danielmoreno510/danny-robot/documentation/research-and-requirements.md

# Investigación y requisitos

**Etapa 1, cerrada salvo la 1.2.** Las cifras de comparación salen de
`analysis/compare_actuators.py` y `results/actuator_comparison.json`.

**Etiquetas:** **V**, dato del fabricante o del proyecto. **S**, tienda. **E**, estimación. **?**,
desconocido.

## 1. Decisiones del usuario (31 de octubre de 2026)

| Tema | Decisión |
|---|---|
| Referencia | El XGO-Duck inspira, no se copia: cada pieza se elige por lo que necesita |
| Forma | Humanoide con aspecto de Tesla Optimus, en pequeño |
| Tamaño | 40 cm: 395 mm en el diseño actual. Sustituye a los 32-36 cm iniciales, que daban aspecto de muñeco |
| Presupuesto | Hasta 1 500 € con repuestos, sin impresora, herramientas ni ordenador de entrenamiento |
| Ordenador | Radxa Zero 3W con cámara, confirmada por el usuario. La Raspberry Pi 5 no cabe en el torso |
| Voz | Hablar con Danny mediante IA en la nube, como objetivo deseable con espacio reservado |
| Entrenamiento | mjlab en la RTX 3080 Ti, en lugar de Isaac Lab |
| Impresora | Cerrada multimaterial |
| Prioridad | Caminar natural y levantarse. El resto, si el diseño lo permite |
| Orden | Diseñar antes de comprar. Medir el servo queda para la etapa 5.1 |

## 2. Requisitos y criterios

Se comprueban en el robot real. Pueden cambiar con justificación escrita.

| Id | Requisito | Criterio | Nivel |
|---|---|---|---|
| R1 | Caminar natural | 0,25 m/s en interior, 5 minutos sin caer, con braceo y giro de torso | Obligatorio |
| R2 | Levantarse | Desde boca arriba y boca abajo, 8 de 10 intentos | Obligatorio |
| R3 | Gestos | Saludo y baile de cuerpo entero sin caer | Obligatorio |
| R4 | Masa | 1,8 kg o menos sin manos y 1,9 kg con manos, medidos. Sube desde 1,6 kg por los 40 cm | Obligatorio |
| R5 | Autonomía | 20 minutos caminando | Obligatorio |
| R6 | Coste | 1 500 € o menos | Obligatorio |
| R7 | Trotar | Pasos rápidos a 0,4 m/s; fase de vuelo si se logra | Deseable |
| R8 | Saltar | Ambos pies a 1 cm del suelo y aterrizar de pie | Deseable |
| R9 | Manipular | Coger con visión un objeto de 50 g de una mesa | Deseable |
| R10 | Proporciones | Altura de 380 a 410 mm, pierna 49 % o más y hombros 34 % o menos de la altura | Obligatorio |
| R11 | Conversación | Responder por voz, con wifi, usando un servicio en la nube, y lanzar un gesto conocido | Deseable |

Se reserva desde el diseño espacio, masa y bus para R9: muñeca, pinza y cámara. Los límites térmicos
se fijan al medir el servo, en la etapa 5.1.

## 3. Referencias

| | XGO-Duck | Microduck | Open Duck Mini | ToddlerBot | Zeroth Bot |
|---|---|---|---|---|---|
| Altura | ? | 25 cm V | 42 cm V | 56 cm V | 48 cm (tabla de ToddlerBot) |
| Masa | ? | Menos de 800 g V | 2,1 kg de modelo V | 3,4 kg V | 3,6 kg (tabla de ToddlerBot) |
| GDL | 15 V | 15 V | 14 V | 30 V | 16 (tabla) |
| Servo | HD-1910-C001 V | XL330 V | STS3215 V | Dynamixel V | Feetech, modelo ? |
| Brazos | No | No | No | Sí | Sí |
| Ordenador | UNO Q V | RK3566 V | Pi Zero 2W V | Jetson Orin NX V | ? |
| Precio | Unos 400 $ | 399 $ V | 398 € V | Unos 6 000 $ V | 350 $ a 1,4 k$, en conflicto |
| Entrenamiento | mjlab, PPO, BAM V | mjlab, PPO, BAM V | MuJoCo Playground V | MJX, Brax V | K-Sim V |

**Conclusiones:**

- **Receta probada para este tamaño:** mjlab, PPO, 50 Hz, modelos de actuador BAM, aleatorización de
  dominio, simulación de holgura y exportación a ONNX. Microduck indica 1-2 horas para una marcha
  usable con 4 096 entornos.
- **Reutilizable:** el código de `xgoduck_rl` es Apache 2.0 e incluye un modelo BAM del servo
  (`1910_m6.json`). `microduck_rl` trae además una guía de recetas de entrenamiento.
- **No reutilizable sin permiso:** las piezas de XGO-Duck, sin licencia final según su `LICENSING.md`.
  Diseñamos las nuestras.
- **Sin precedente:** no he encontrado ningún humanoide con brazos que camine con HD-1910. Es el mayor
  riesgo del proyecto.

## 4. Comparación de actuadores

| Servo | Tensión | Bloqueo | Nominal | Vacío | Masa | Precio |
|---|---|---|---|---|---|---|
| Feetech HD-1910-C001 | 7,4 V (máx. 8,4) | 1,47 N·m V | 0,36 N·m V | 11,9 rad/s V | 21 g V | 29,95-32,95 € S |
| STS3215 C018 | 12 V | 2,94 N·m S | 0,98 N·m S | 4,7 rad/s S | 55 g S | 26,51 € S |
| STS3215 C044 | 7,4 V | 1,6 o 2,7 N·m, en conflicto S | 0,88 N·m S | 9,0 rad/s S | 55 g S | 21,89-23,57 € S |

El HD-1910 tiene reducción 1:320, motor sin núcleo, holgura hasta 0,5° y encoder de 12 bits (V). Las
fichas del HD-1910 discrepan en el par: 10 kg·cm a 6 V en la wiki de Feetech, y 12 kg·cm a 6 V y 15 kg·cm
a 7,4 V en la ficha del proveedor que recoge el XGO-Duck. Se usa esta última, la más optimista: hay que
confirmarla al medir. **El par continuo real está sin medir.**

Primer orden con 12 servos de pierna, margen de 1,5 y velocidad en vacío como techo:

| Reparto, 40 cm, 23 GDL | Masa | Par pico con margen | Supera nominal | Marcha humana equivalente | Salto cargado |
|---|---|---|---|---|---|
| **Todo HD-1910** | 1,78 kg | 65 % del bloqueo | Sí | **1,12 m/s** | 2,1 cm |
| Piernas C044, arriba HD-1910 | 2,19 kg | 73 % del bloqueo | Sí | 0,85 m/s | 1,2 cm |
| Todo C018 | 2,56 kg | 47 % del bloqueo | Sí | 0,44 m/s | 0,3 cm |

Con 27 GDL y todo HD-1910, 1,87 kg y 68 %. Es la estimación alta: la pieza a pieza da 1,66 kg.

**Lectura:**

- **Candidato: todo HD-1910.** Mezclar con STS3215 en las piernas pesa más y va más lento. El C018
  necesita además 12 V, por encima de los 8,4 V del HD-1910.
- **Punto débil: el calor.** Los picos superan los 0,36 N·m nominales. Hay que medir si aguanta el
  apoyo a un pie. Si no, las opciones son reducir masa o reforzar solo las articulaciones
  que fallen.
- **Saltar y correr:** con la reducción 1:320, el salto estimado es de unos 2 cm, con techo teórico de 6
  cm. La velocidad en vacío no se alcanza bajo carga, y el 60 % usado es una estimación. El aterrizaje
  no está evaluado y puede dañar los engranajes. R7 y R8 pueden requerir actuadores de menor reducción.

Este estudio simplifica mucho: la masa de estructura se escala desde Open Duck, ignora la curva
par-velocidad y no incluye levantarse, que puede ser la carga mayor en los hombros.

**Datos de diseño del HD-1910 (S, ArmDojo):** 29 mm de grosor con ambos ejes; eje doble para horquillas;
dos conectores para encadenar servos; lee posición, carga, corriente, tensión y temperatura; modo PD de
posición; corte por temperatura a 80 °C; 2S llena llega a 8,4 V, el máximo del servo.

**Riesgo de diseñar antes de medir:** el calor y la curva real se conocerán en la etapa 5.1. Si fallan,
habrá que rediseñar las piezas que sujetan el servo, y volver a entrenar.

## 5. Precios del banco de pruebas

Consultados el 31 de octubre de 2026, como referencia. El usuario ya compró 3 servos, FE-URT-2 y fuente.

| Concepto | Vendedor | Precio | Disponibilidad |
|---|---|---|---|
| 2 HD-1910-C001 | OpenELAB | 63,96 € con IVA (31,98 € cada uno) | Envío desde China en 5-10 días laborables |
| FE-URT-2 | OpenELAB | 15,96 € | No comprobada |
| 15 HD-1910 + FE-URT-2 | ArmDojo | 393,95 €, sin IVA ni aranceles | En stock, desde Singapur |
| Fuente de 3-12 V, 5 A | ArmDojo | 17,95 €, enchufe de EE. UU. | No comprobada |

**Total estimado: 100-120 € (E)**, con fuente y envío. Falta una carga conocida para identificar el servo: un
brazo impreso y botellas de agua pesadas en la báscula. A 100 mm del eje, el bloqueo de 0,94 N·m equivale a unos
0,96 kg. Falta también confirmar cómo entra la alimentación en la FE-URT-2: lo encontrado apunta a bornes de tornillo,
sin manual oficial leído. No pude leer RCDrone.

## 6. Fuentes de movimiento humano (etapa 1.2)

Investigado el 4 de noviembre de 2026 en las páginas oficiales de cada fuente. Las licencias de CMU, 100STYLE y LAFAN1 se
volvieron a leer en su página. No es asesoría legal. El repositorio es público y aún no tiene licencia, así que importa poder
publicar las trayectorias retargeteadas al robot, no solo usarlas.

| Fuente | Licencia | Publicar trayectorias de Danny | Uso comercial | Formato | Contenido útil |
|---|---|---|---|---|---|
| [CMU Mocap](http://mocap.cs.cmu.edu/) | Propia: "copied, modified, or redistributed without permission" | Sí, sin revender los datos | Sí, dentro de un producto | ASF/AMC y c3d; sin SMPL | Andar, gestos, bailes y sentarse. Que tenga levantarse del suelo no está comprobado |
| [100STYLE](https://www.ianxmason.com/100style/) | CC BY 4.0 | Sí, citando "The 100STYLE Dataset - Ian Mason" | Sí | BVH; sin SMPL | Solo locomoción: 100 estilos hacia delante, atrás y de lado, con transiciones |
| [Bandai Namco Research](https://github.com/BandaiNamcoResearchInc/Bandai-Namco-Research-Motiondataset) | CC BY-NC 4.0 | Sí, sin fin comercial | No | BVH | Vida diaria, bailes y gestos con estilos |
| [Ubisoft LAFAN1](https://github.com/ubisoft/ubisoft-laforge-animation-dataset) | CC BY-NC-ND 4.0 | **No**: ND prohíbe publicar lo adaptado | No | BVH | Andar, bailar, caer y levantarse. Es la que usan mjlab y BeyondMimic |
| Retargeting de LAFAN1 de Unitree | Hereda NC-ND de LAFAN1 | No | No | CSV para G1 y H1 | El de LAFAN1, para otro robot |
| [AMASS](https://amass.is.tue.mpg.de/license.html) y modelo SMPL/SMPL-X | Propia de MPI, investigación no comercial | No | No | SMPL | Más de 40 h; necesita registro |
| SFU, Motion-X, HumanML3D | No comercial; SFU no aclara la redistribución | No o sin aclarar | No | Varios | Repiten lo anterior |
| KIT Whole-Body | Sin licencia publicada | Sin verificar | Sin verificar | c3d | Habría que preguntar a KIT |
| Mixamo | Los términos de Adobe prohíben entrenar aprendizaje automático con sus resultados (sección 17(C)) | No | — | FBX | Descartada |

**Herramientas:** [GMR](https://github.com/YanjieZe/GMR) (MIT) retargetea BVH sin SMPL, así que CMU y 100STYLE no necesitan
el modelo SMPL. mjlab (Apache 2.0) imita movimientos desde CSV con la convención de Unitree. Grabar al usuario con el móvil
(WHAM, GVHMR) depende de SMPL, que no es comercial, y GVHMR solo permite investigación: queda para más adelante.

**Laguna:** ninguna licencia dice si los pesos de una política entrenada cuentan como obra derivada.

**Recomendación:** CMU como base y 100STYLE para estilos de marcha. Permiten publicar todo con cualquier licencia del repositorio.
LAFAN1 solo en local, sin subir lo derivado, y solo si hace falta para levantarse.

**Decisión del usuario, 4 de noviembre de 2026:** CMU y 100STYLE. Se descargan de su página oficial, no de AMASS, cuyos
términos mandarían sobre la copia de CMU que incluye. Se cita "obtained from mocap.cs.cmu.edu" y "The 100STYLE Dataset - Ian Mason".

## 7. Preguntas abiertas de la etapa 1

- Si `1910_m6.json` coincide con nuestros servos: se resuelve en la etapa 5.1. Si HD-1910 y STS3215 conviven en un
  bus solo importa si se llegan a mezclar.
- Otros actuadores compactos para las piernas, para R7 y R8.
- ACDC4Robot: comprobar con un modelo simple que exporta bien a MJCF desde Fusion.

## 8. Fuentes

[XGO-Duck](https://github.com/LuwuDynamics/xgoduck_hardware) ·
[HD-1910 en ArmDojo](https://armdojo.com/products/feetech-hd-1910-c001-coreless-servo-microduck) ·
[Ficha del servo en XGO-Duck](https://github.com/LuwuDynamics/xgoduck_hardware/blob/main/docs/BOM.md) ·
[xgoduck_rl](https://github.com/LuwuDynamics/xgoduck_rl) ·
[Licencias de XGO-Duck](https://github.com/LuwuDynamics/xgoduck_hardware/blob/main/LICENSING.md) ·
[Guía de XGO-Duck](https://xgo-duck.com/) ·
[Compra de servos](https://www.roboduckbuild.com/diary/sixteen-servos-on-pre-order/) ·
[HD-1910 en OpenELAB](https://openelab.io/products/feetech-hd1910-microduck-coreless-servo) ·
[Wiki de Feetech](https://ftservo.github.io/ftservo-wiki/en/products/models/hd-1910-c001/main/) ·
[Microduck](https://pollen-robotics.com/microduck/blog/introducing-microduck/) ·
[Runtime de Microduck](https://github.com/pollen-robotics/microduck) ·
[microduck_rl](https://github.com/pollen-robotics/microduck_rl) ·
[mjlab](https://github.com/mujocolab/mjlab) ·
[BAM](https://github.com/Rhoban/bam) ·
[Open Duck Mini](https://github.com/apirrone/Open_Duck_Mini/tree/v2) ·
[ToddlerBot](https://arxiv.org/html/2502.00893v3) ·
[Zeroth Bot](https://github.com/zeroth-robotics/zeroth-bot) ·
[ACDC4Robot](https://github.com/ACDC4Robot/Fusion360)
