danielmoreno510/danny-robot/cad/export/danny/meshes/right_shin_1.stl

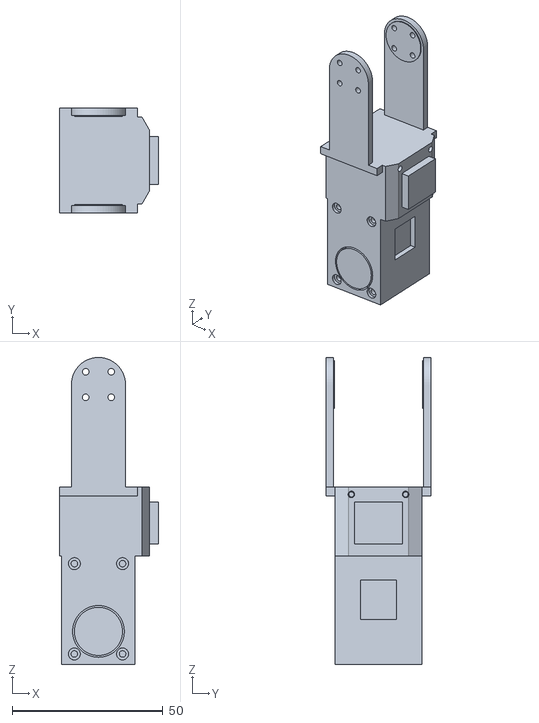
[picture p1: CAD file, 2026-11-02]
cad/export/danny/meshes/right_shin_1.stl
33.0 x 35.0 x 102.0
