danielmoreno510/danny-robot/cad/export/export_test/meshes/arm_link_1.stl

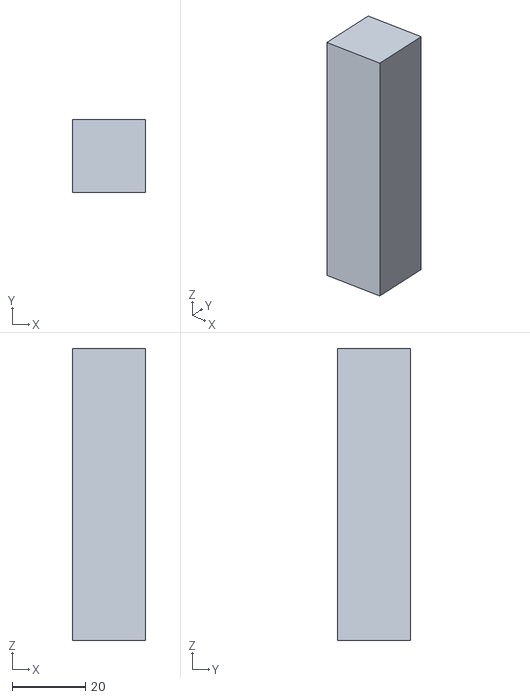
[picture p2: CAD file, 2026-10-31]
cad/export/export_test/meshes/arm_link_1.stl
20.0 x 20.0 x 80.0
