danielmoreno510/danny-robot/cad/print/right_hip_roll_link_cover.stl

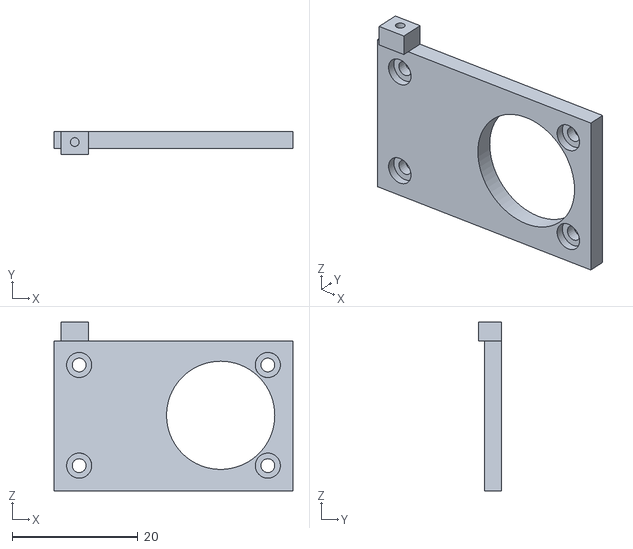
[picture p3: CAD file, 2026-11-02]
cad/print/right_hip_roll_link_cover.stl
38.0 x 3.70 x 26.8
