danielmoreno510/danny-robot/cad/export/danny/meshes/base_link.stl

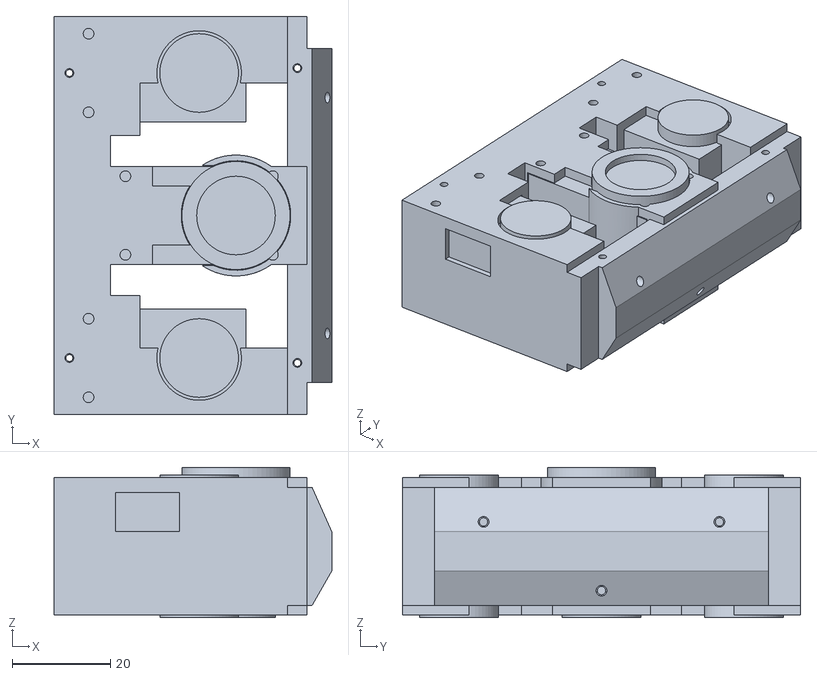
[picture p4: CAD file, 2026-11-02]
cad/export/danny/meshes/base_link.stl
56.5 x 81.0 x 30.6
