danielmoreno510/danny-robot/cad/export/export_test/meshes/base_link.stl

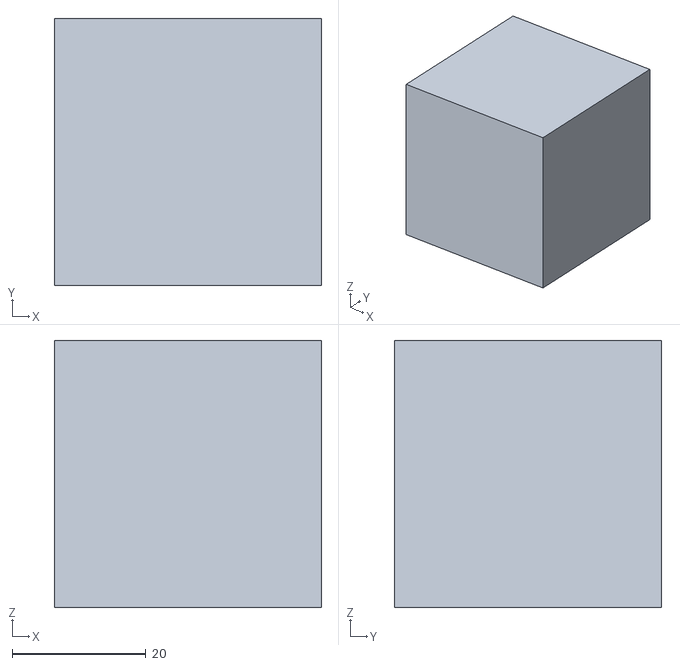
[picture p5: CAD file, 2026-10-31]
cad/export/export_test/meshes/base_link.stl
40.0 x 40.0 x 40.0
