danielmoreno510/danny-robot/cad/print/left_hip_yaw_link_structure.stl

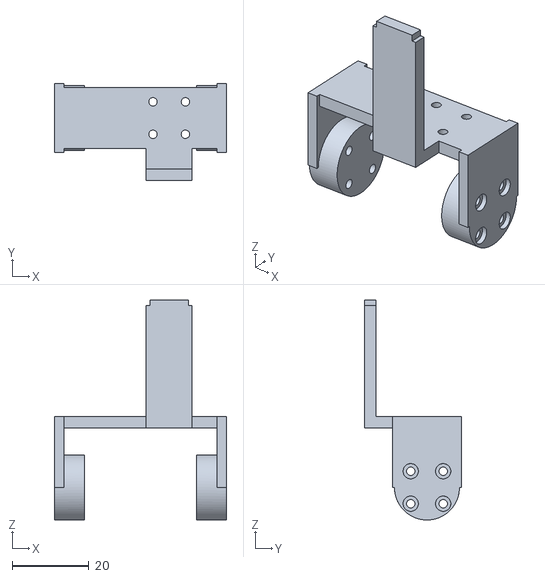
[picture p6: CAD file, 2026-11-02]
cad/print/left_hip_yaw_link_structure.stl
45.0 x 25.3 x 57.5
