danielmoreno510/danny-robot/cad/export/danny/meshes/left_foot_1.stl

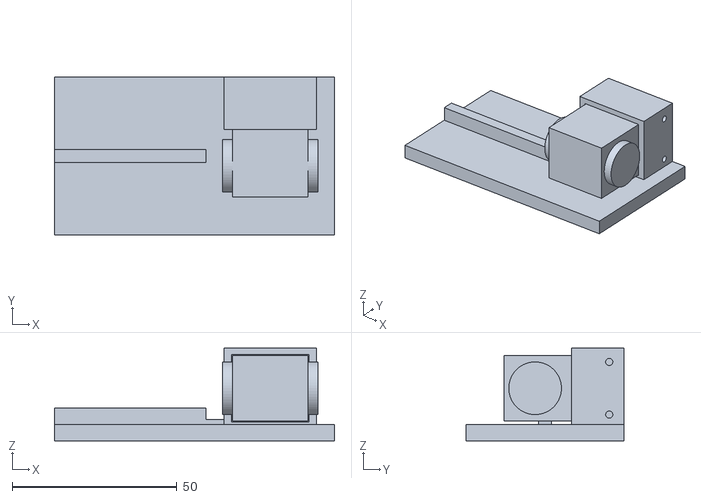
[picture p7: CAD file, 2026-11-02]
cad/export/danny/meshes/left_foot_1.stl
85.0 x 48.0 x 28.2
