danielmoreno510/danny-robot/cad/print/left_hip_yaw_link_cover.stl

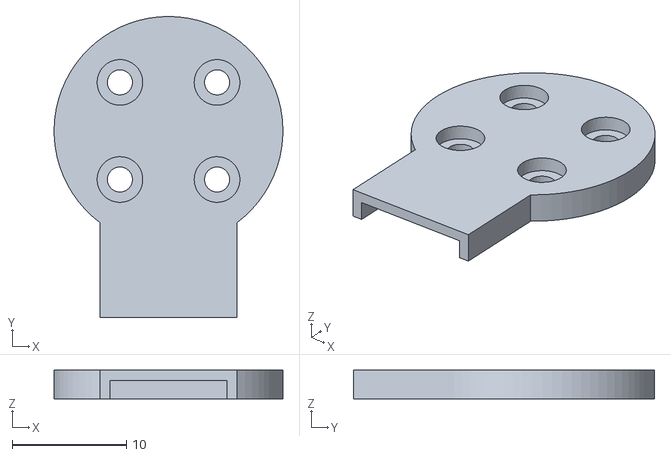
[picture p8: CAD file, 2026-11-02]
cad/print/left_hip_yaw_link_cover.stl
20.0 x 26.3 x 2.50
