danielmoreno510/danny-robot/cad/print/torso_structure.stl

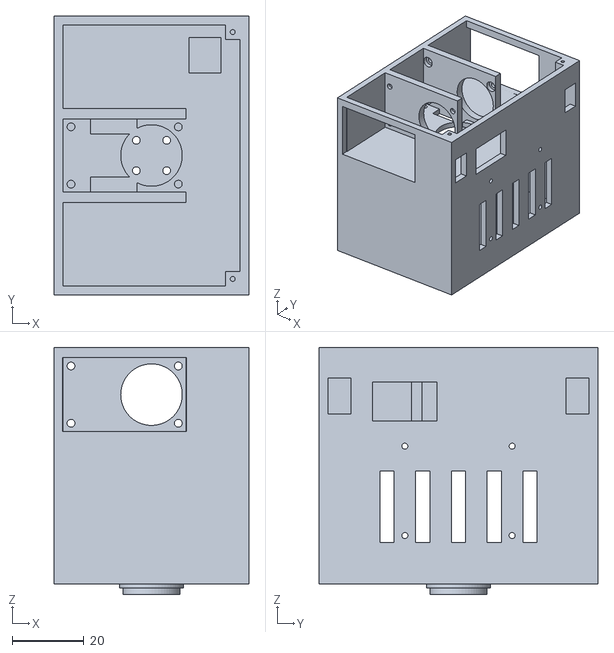
[picture p9: CAD file, 2026-11-02]
cad/print/torso_structure.stl
54.4 x 78.0 x 69.1
