danielmoreno510/danny-robot/cad/export/danny/meshes/torso_1.stl

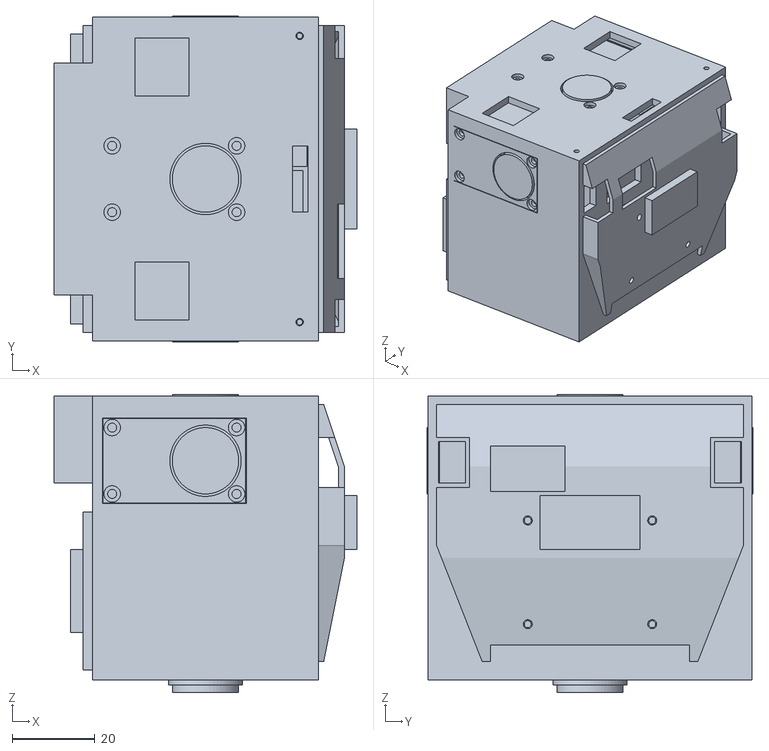
[picture p10: CAD file, 2026-11-02]
cad/export/danny/meshes/torso_1.stl
73.0 x 78.6 x 71.9
