danielmoreno510/danny-robot/cad/print/left_shin_panel.stl

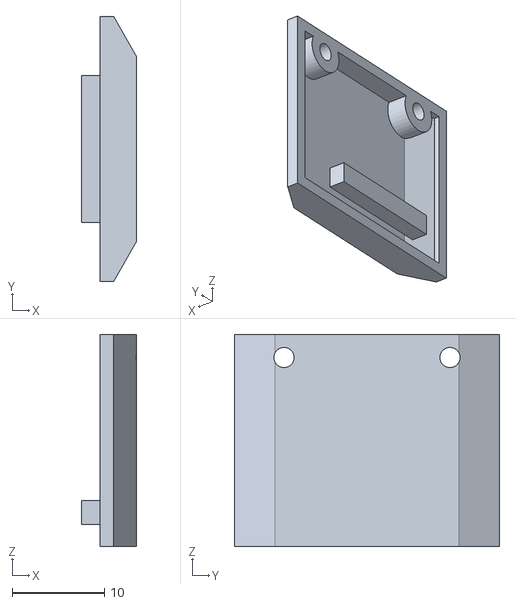
[picture p11: CAD file, 2026-11-02]
cad/print/left_shin_panel.stl
6.00 x 28.8 x 23.0
