danielmoreno510/danny-robot/cad/export/danny/meshes/right_hip_roll_link_1.stl

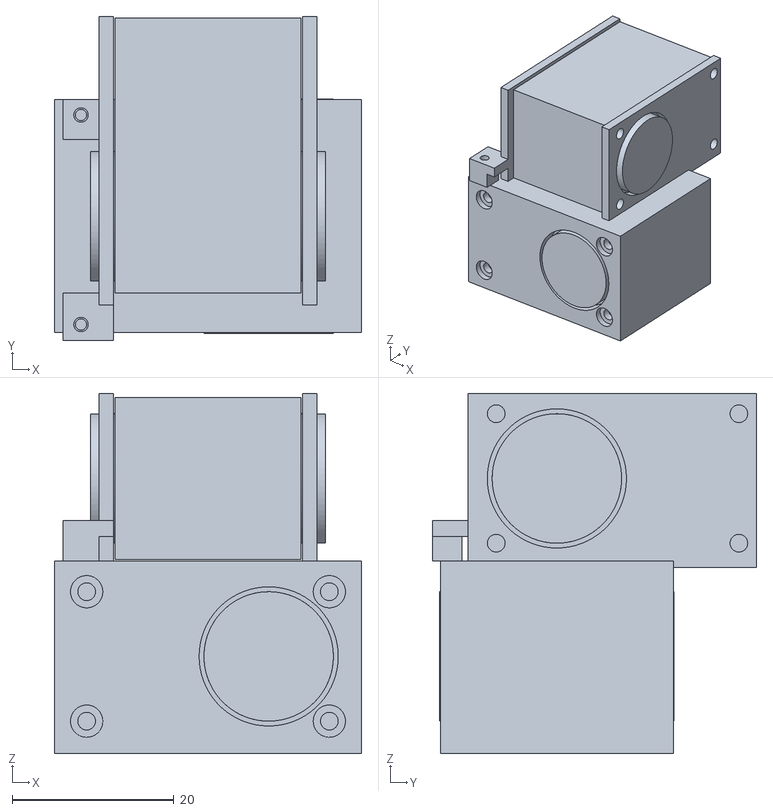
[picture p12: CAD file, 2026-11-02]
cad/export/danny/meshes/right_hip_roll_link_1.stl
38.0 x 40.1 x 44.5
