danielmoreno510/danny-robot/cad/print/right_hip_roll_link_plate.stl

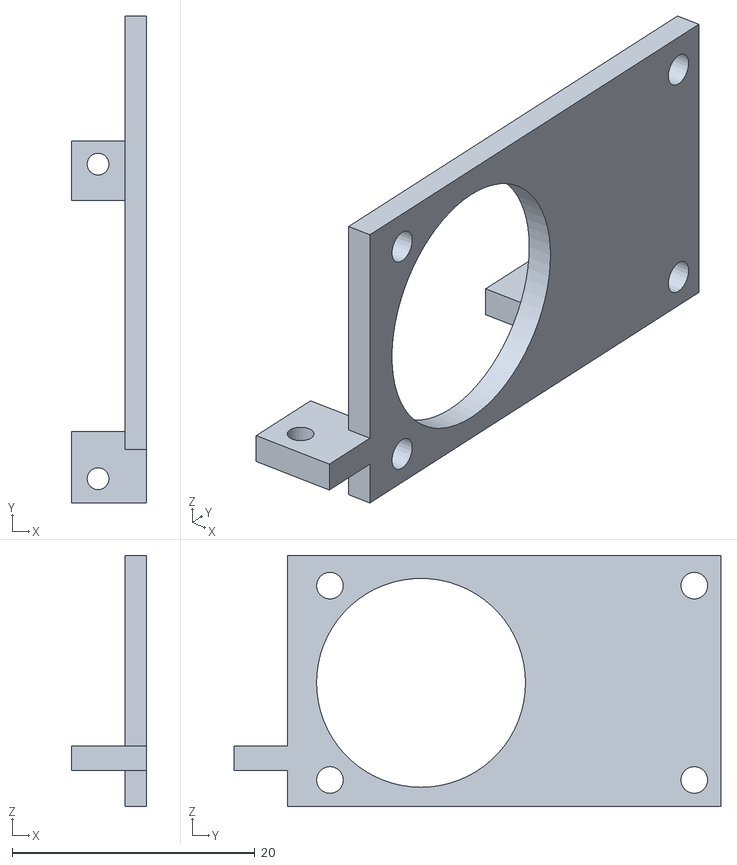
[picture p13: CAD file, 2026-11-02]
cad/print/right_hip_roll_link_plate.stl
6.20 x 40.1 x 20.7
