danielmoreno510/danny-robot/cad/export/danny/meshes/right_thigh_1.stl

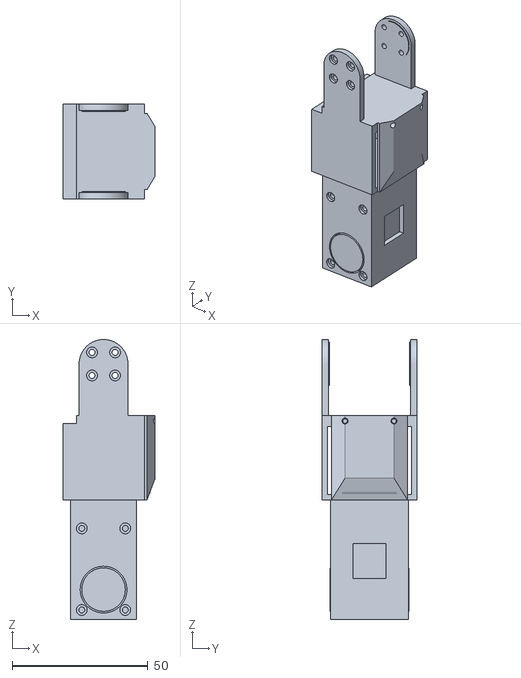
[picture p14: CAD file, 2026-11-02]
cad/export/danny/meshes/right_thigh_1.stl
34.0 x 35.0 x 103.0
