danielmoreno510/danny-robot/cad/export/danny/meshes/right_hip_yaw_link_1.stl

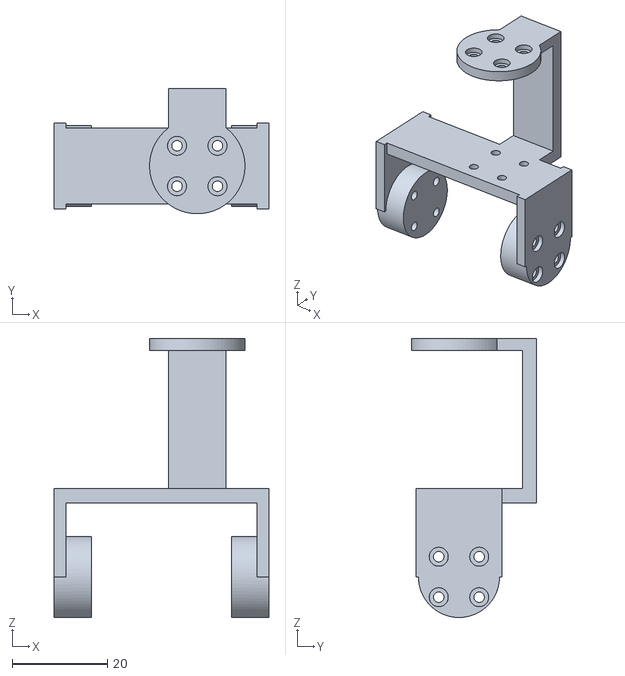
[picture p15: CAD file, 2026-11-02]
cad/export/danny/meshes/right_hip_yaw_link_1.stl
45.0 x 26.3 x 58.5
