danielmoreno510/danny-robot/cad/print/right_thigh_structure.stl

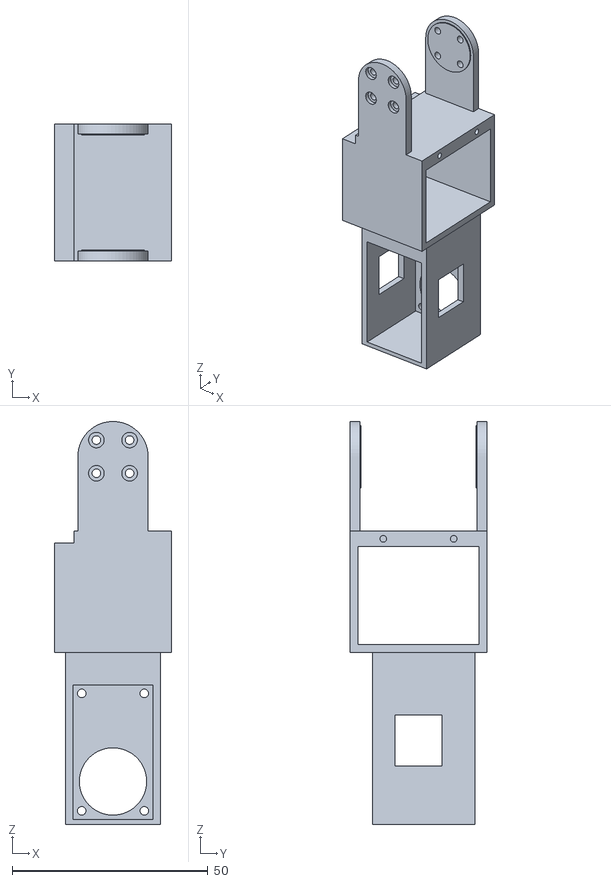
[picture p16: CAD file, 2026-11-02]
cad/print/right_thigh_structure.stl
30.0 x 35.0 x 103.0
