danielmoreno510/danny-robot/cad/print/left_foot_structure.stl

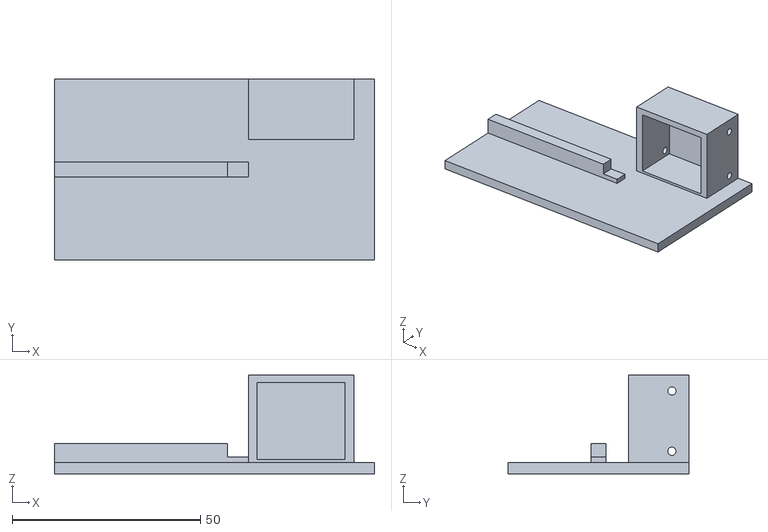
[picture p17: CAD file, 2026-11-02]
cad/print/left_foot_structure.stl
85.0 x 48.0 x 26.2
