danielmoreno510/danny-robot/cad/export/danny/meshes/left_upper_arm_1.stl

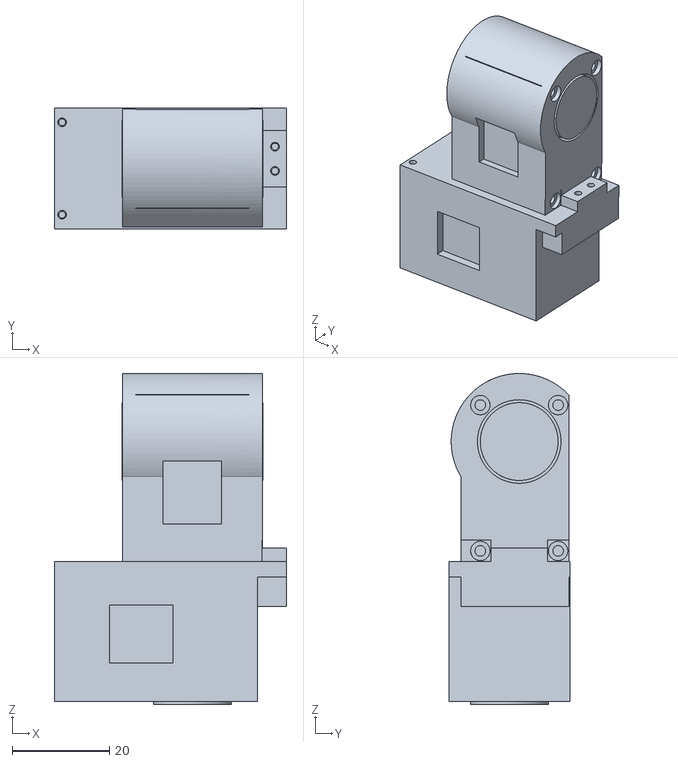
[picture p18: CAD file, 2026-11-02]
cad/export/danny/meshes/left_upper_arm_1.stl
47.8 x 24.8 x 68.1
