danielmoreno510/danny-robot/cad/print/torso_tray_plate.stl

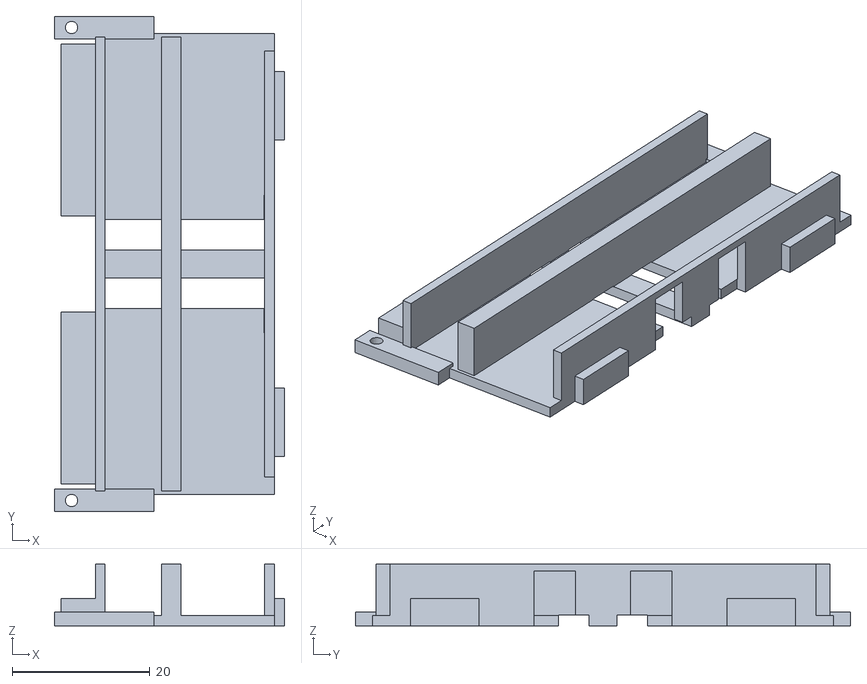
[picture p19: CAD file, 2026-11-02]
cad/print/torso_tray_plate.stl
33.5 x 72.0 x 9.00
