danielmoreno510/danny-robot/cad/print/right_shin_structure.stl

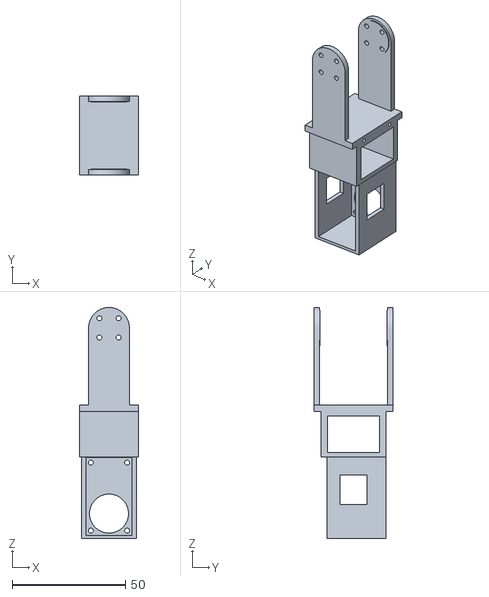
[picture p20: CAD file, 2026-11-02]
cad/print/right_shin_structure.stl
26.0 x 35.0 x 102.0
