danielmoreno510/danny-robot/cad/export/danny/meshes/right_forearm_1.stl

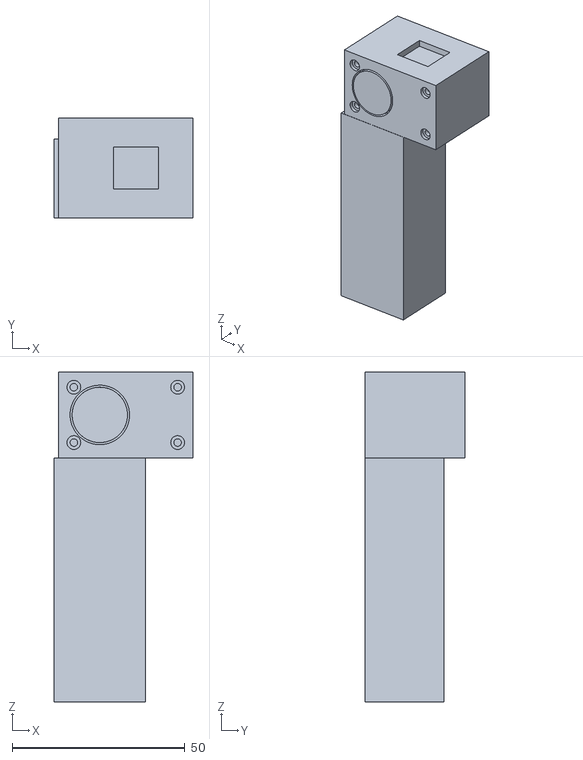
[picture p21: CAD file, 2026-11-02]
cad/export/danny/meshes/right_forearm_1.stl
40.1 x 29.0 x 95.4
