danielmoreno510/danny-robot/cad/export/danny/meshes/right_ankle_link_1.stl

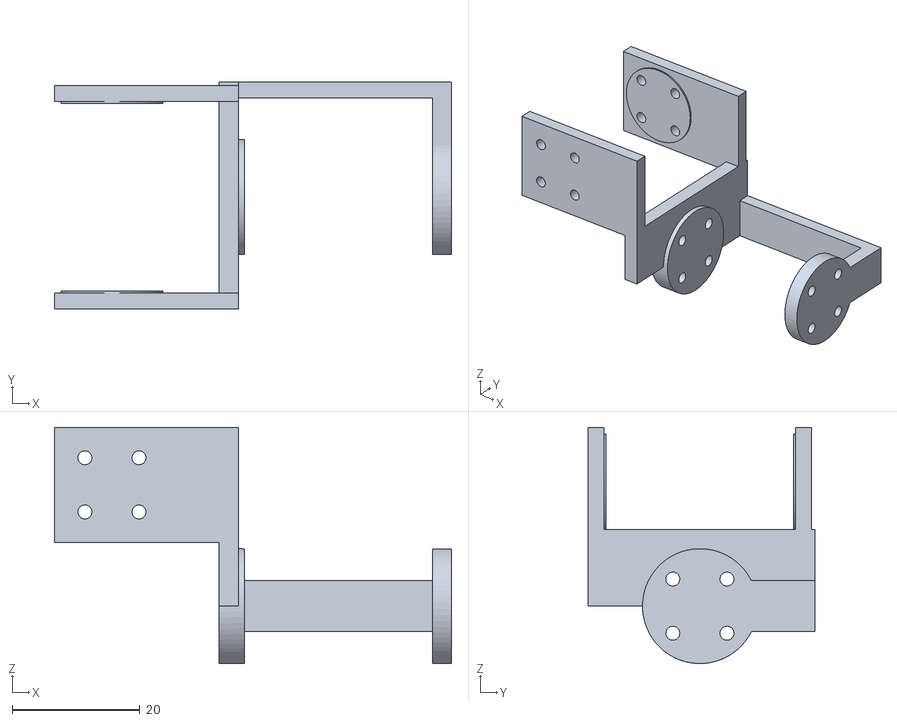
[picture p22: CAD file, 2026-10-31]
cad/export/danny/meshes/right_ankle_link_1.stl
62.2 x 35.5 x 37.0
