danielmoreno510/danny-robot/cad/print/base_link_cover.stl

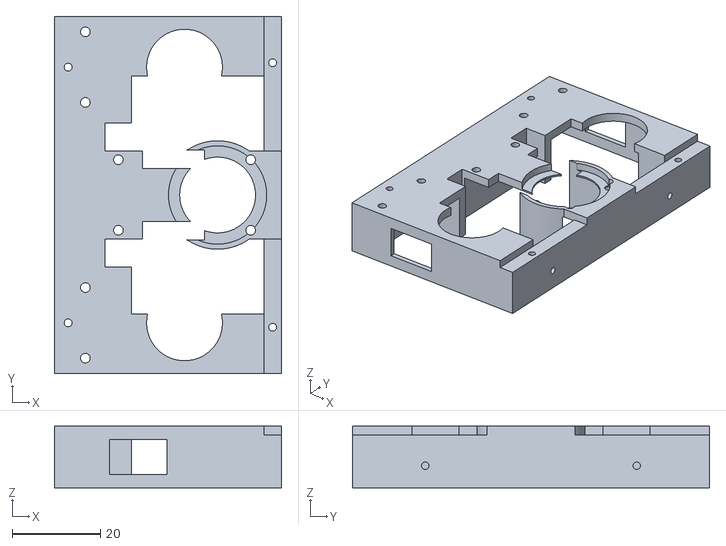
[picture p23: CAD file, 2026-11-02]
cad/print/base_link_cover.stl
51.5 x 81.0 x 14.0
