danielmoreno510/danny-robot/cad/export/danny/meshes/right_elbow_link_1.stl

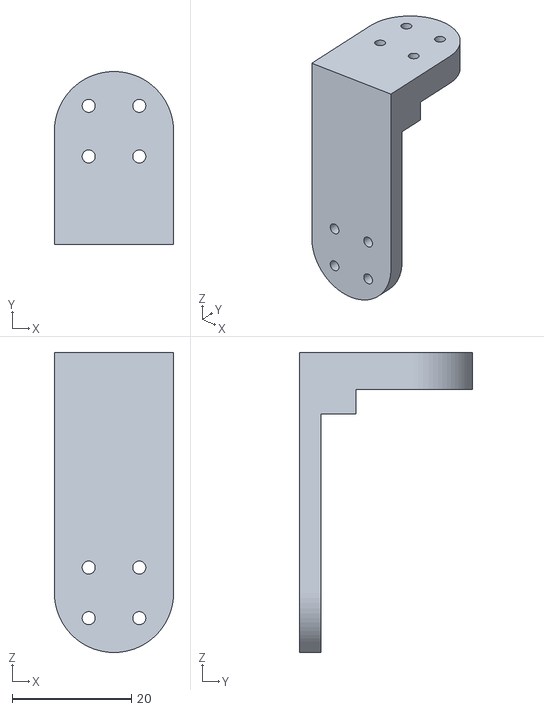
[picture p24: CAD file, 2026-10-31]
cad/export/danny/meshes/right_elbow_link_1.stl
20.0 x 29.0 x 50.3
