danielmoreno510/danny-robot/cad/print/right_hip_roll_link_structure.stl

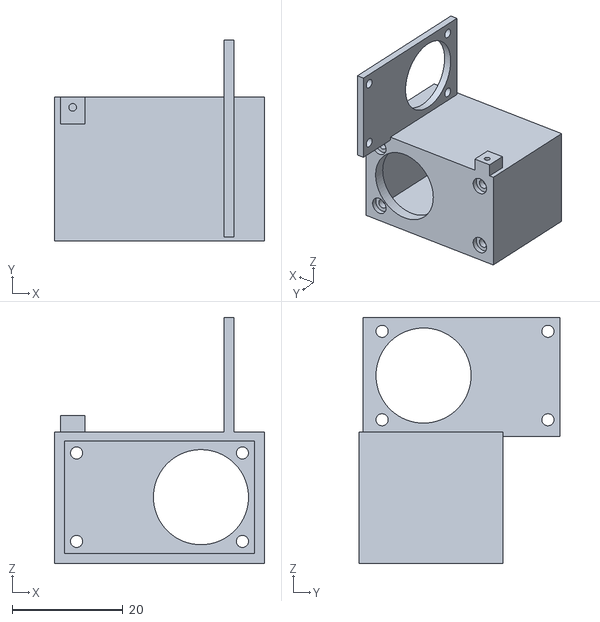
[picture p25: CAD file, 2026-11-02]
cad/print/right_hip_roll_link_structure.stl
38.0 x 36.4 x 44.5
