danielmoreno510/danny-robot/cad/export/danny/meshes/neck_link_1.stl

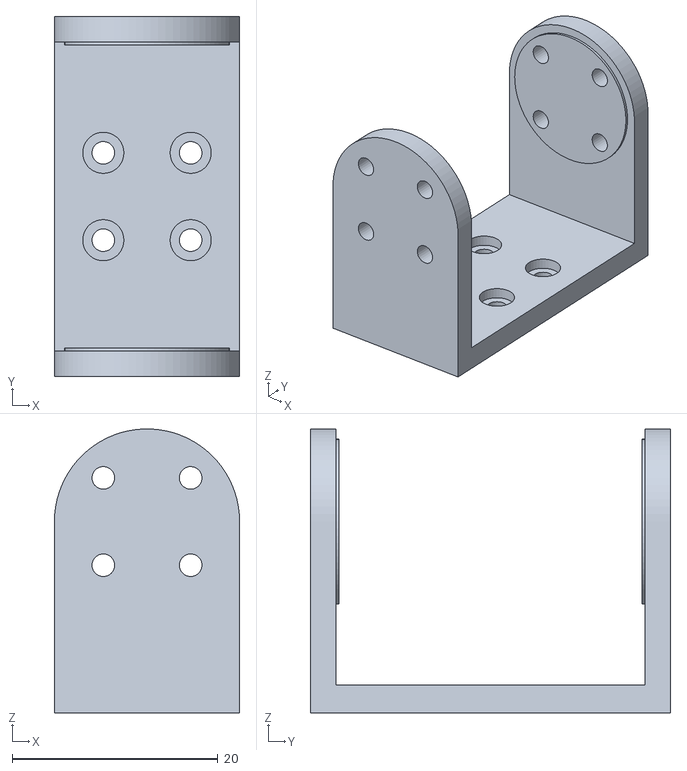
[picture p26: CAD file, 2026-10-31]
cad/export/danny/meshes/neck_link_1.stl
18.0 x 35.0 x 27.6
