danielmoreno510/danny-robot/cad/export/danny/meshes/left_shoulder_link_1.stl

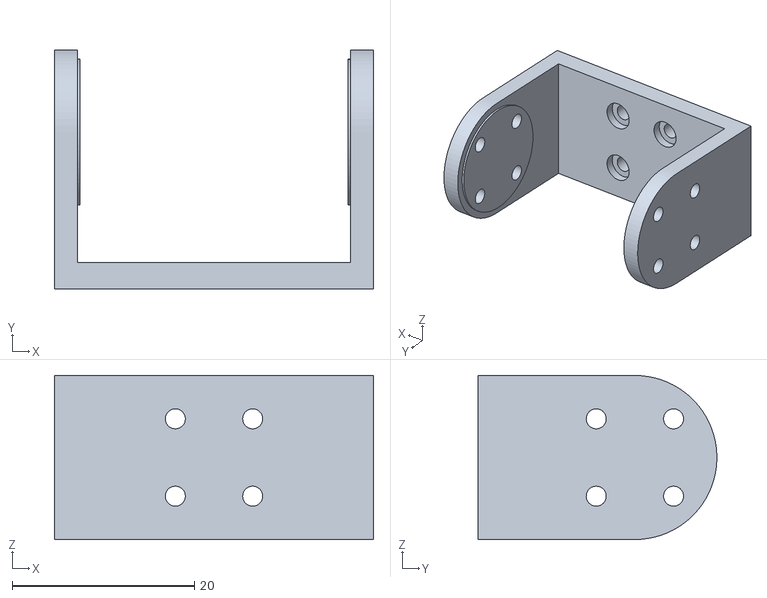
[picture p27: CAD file, 2026-10-31]
cad/export/danny/meshes/left_shoulder_link_1.stl
35.0 x 26.2 x 18.0
