danielmoreno510/danny-robot/cad/print/torso_back_hump_pad.stl

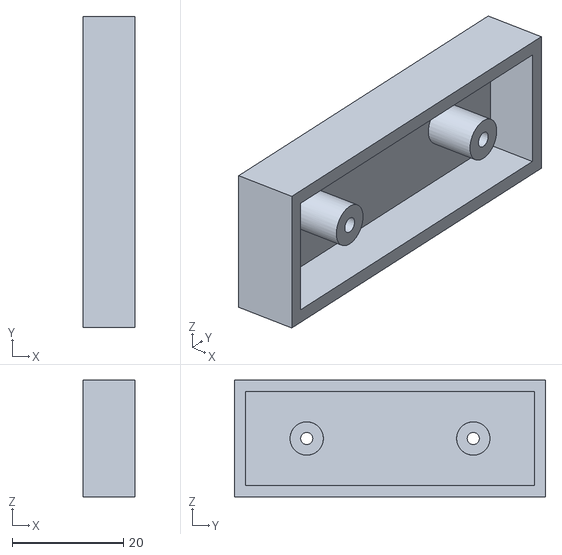
[picture p28: CAD file, 2026-11-02]
cad/print/torso_back_hump_pad.stl
9.30 x 56.0 x 21.0
