danielmoreno510/danny-robot/cad/export/danny/meshes/head_1.stl

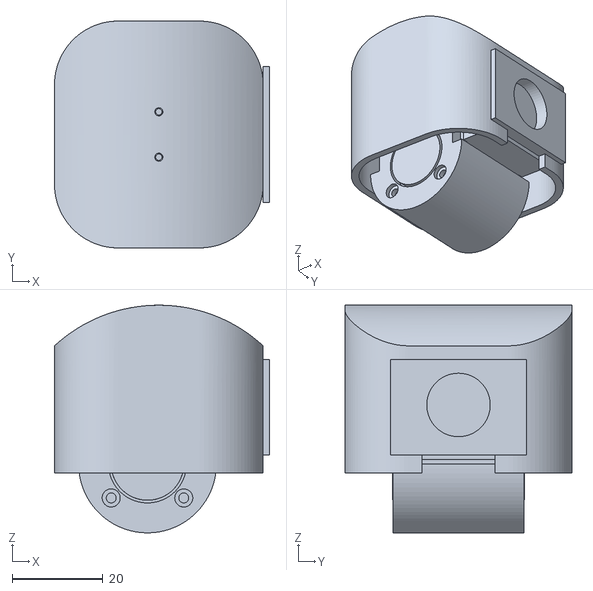
[picture p29: CAD file, 2026-10-31]
cad/export/danny/meshes/head_1.stl
47.4 x 50.0 x 50.2
