danielmoreno510/danny-robot/cad/print/left_upper_arm_plate.stl

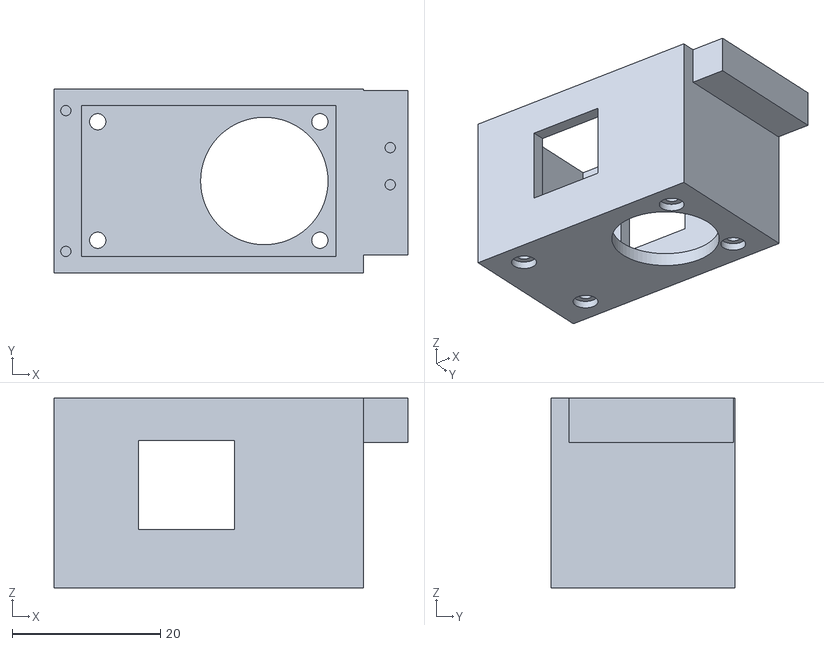
[picture p30: CAD file, 2026-11-02]
cad/print/left_upper_arm_plate.stl
47.8 x 24.8 x 25.6
