danielmoreno510/danny-robot/cad/print/right_forearm_structure.stl

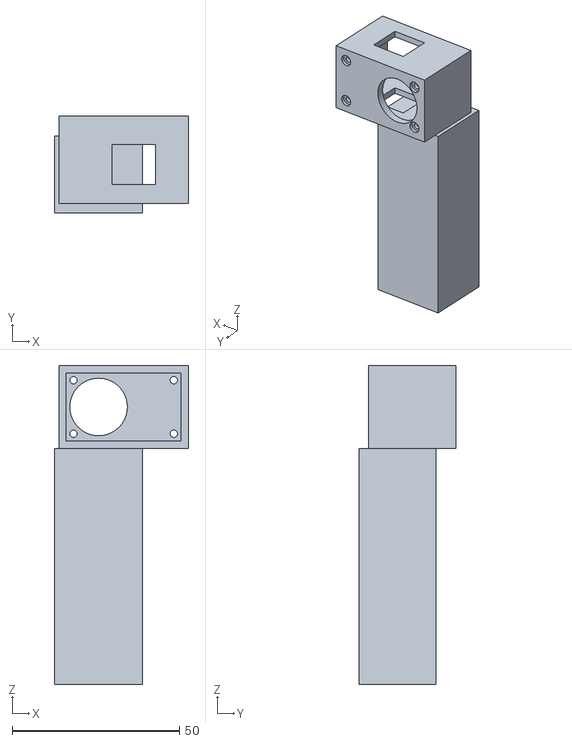
[picture p31: CAD file, 2026-11-02]
cad/print/right_forearm_structure.stl
40.1 x 28.9 x 95.4
