danielmoreno510/danny-robot/cad/print/right_upper_arm_structure.stl

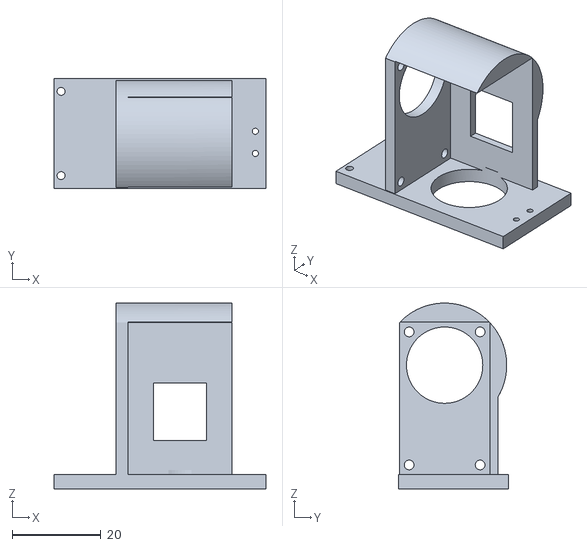
[picture p32: CAD file, 2026-11-02]
cad/print/right_upper_arm_structure.stl
47.8 x 24.8 x 41.9
