danielmoreno510/danny-robot/cad/print/left_upper_arm_cover.stl

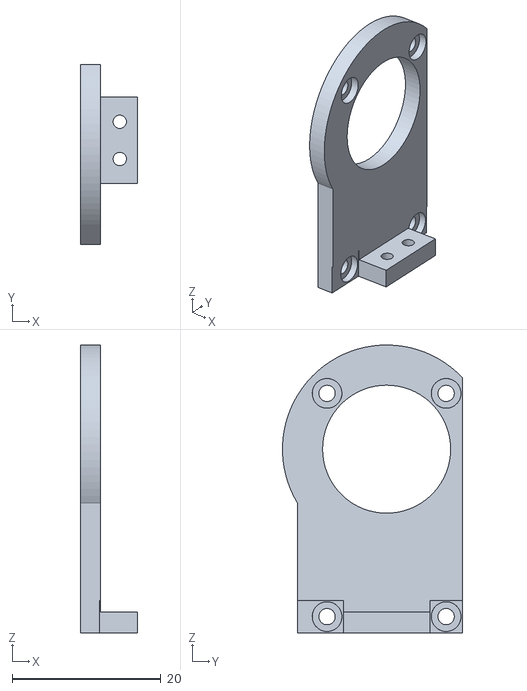
[picture p33: CAD file, 2026-11-02]
cad/print/left_upper_arm_cover.stl
7.70 x 24.2 x 38.7
