danielmoreno510/danny-robot/cad/print/torso_rear_cover.stl

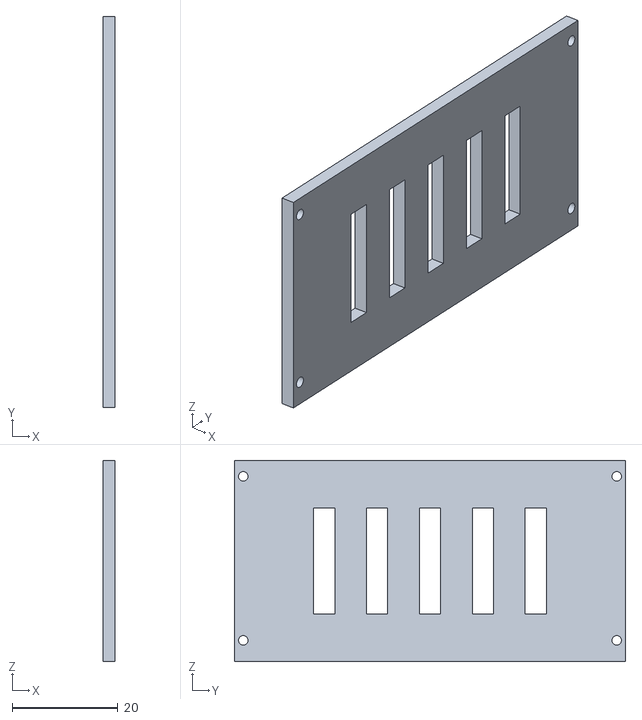
[picture p34: CAD file, 2026-11-02]
cad/print/torso_rear_cover.stl
2.30 x 74.0 x 38.0
