danielmoreno510/danny-robot/cad/print/right_thigh_panel.stl

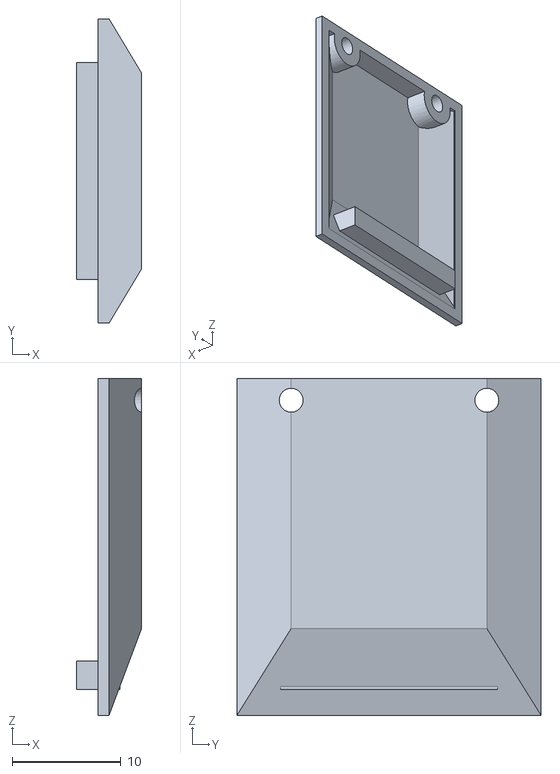
[picture p35: CAD file, 2026-11-02]
cad/print/right_thigh_panel.stl
6.00 x 28.0 x 31.0
