danielmoreno510/danny-robot/cad/print/right_foot_sole.stl

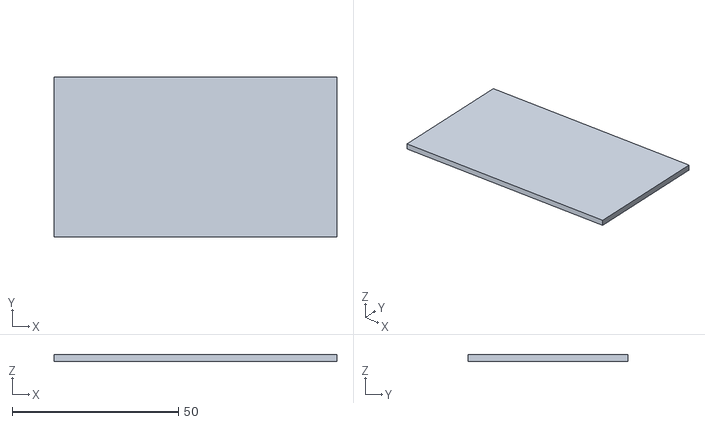
[picture p36: CAD file, 2026-10-31]
cad/print/right_foot_sole.stl
85.0 x 48.0 x 2.00
