danielmoreno510/danny-robot/cad/print/right_shin_cover.stl

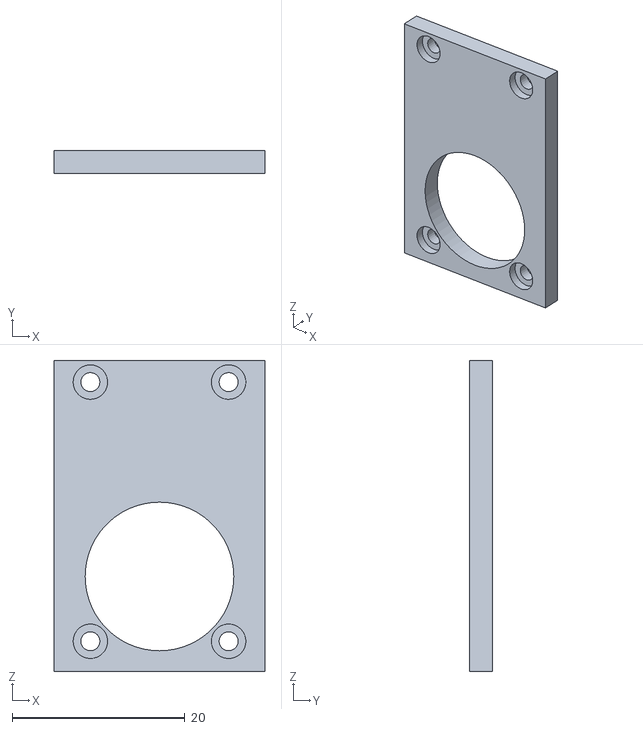
[picture p37: CAD file, 2026-10-31]
cad/print/right_shin_cover.stl
24.4 x 2.70 x 36.0
