danielmoreno510/danny-robot/cad/print/head_visor_panel.stl

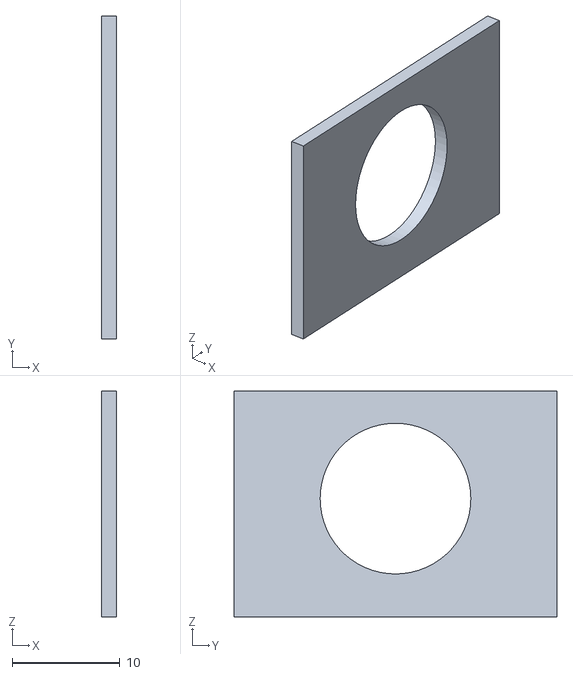
[picture p38: CAD file, 2026-10-31]
cad/print/head_visor_panel.stl
1.40 x 30.0 x 21.0
