danielmoreno510/danny-robot/cad/print/left_shin_pad.stl

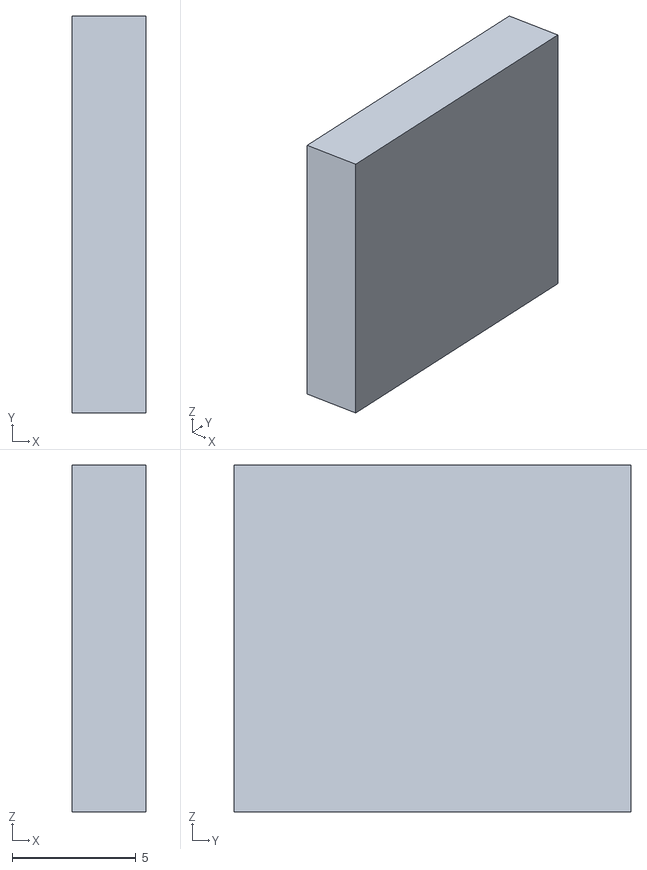
[picture p39: CAD file, 2026-10-31]
cad/print/left_shin_pad.stl
3.00 x 16.0 x 14.0
