danielmoreno510/danny-robot/cad/print/torso_right_back_pad.stl

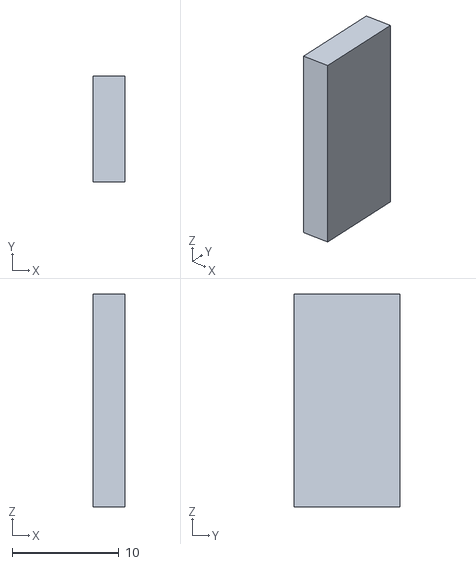
[picture p40: CAD file, 2026-10-31]
cad/print/torso_right_back_pad.stl
3.00 x 10.0 x 20.0
