danielmoreno510/danny-robot/cad/print/left_forearm_cover.stl

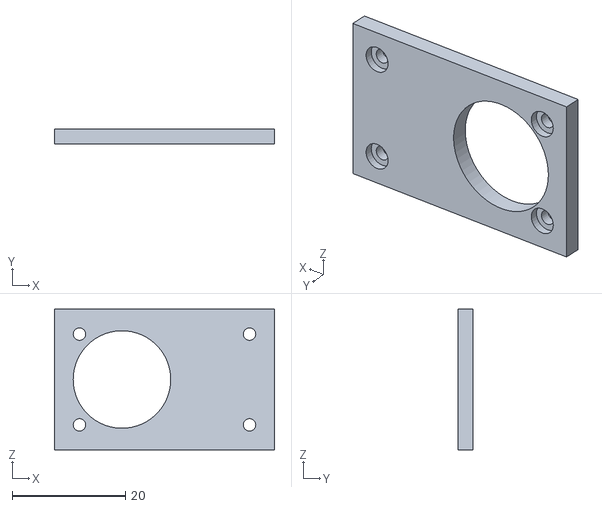
[picture p41: CAD file, 2026-10-31]
cad/print/left_forearm_cover.stl
38.8 x 2.70 x 24.8
