danielmoreno510/danny-robot/cad/print/torso_top_plate.stl

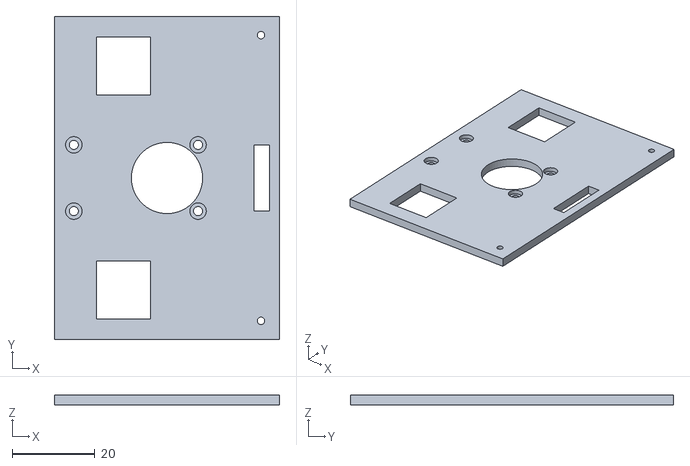
[picture p42: CAD file, 2026-10-31]
cad/print/torso_top_plate.stl
54.4 x 78.0 x 2.40
