danielmoreno510/danny-robot/cad/print/head_structure.stl

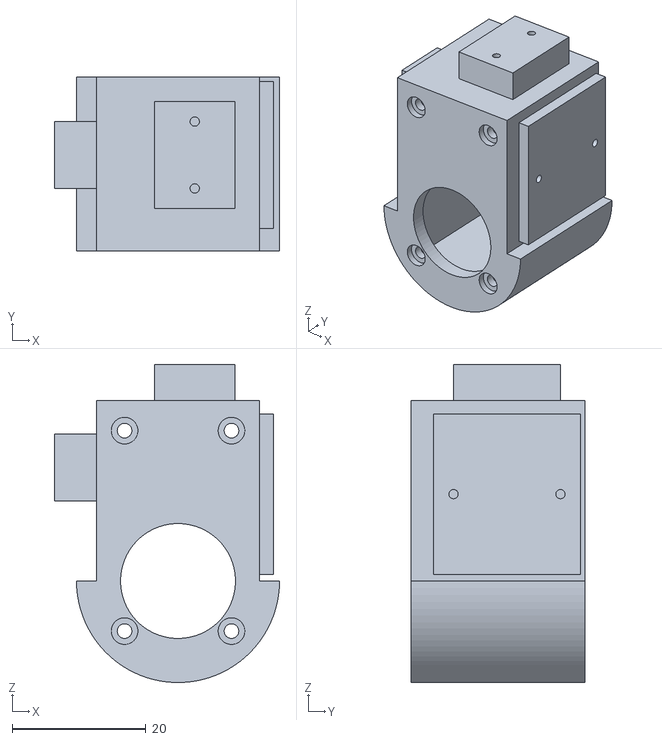
[picture p43: CAD file, 2026-10-31]
cad/print/head_structure.stl
33.7 x 26.1 x 47.6
