danielmoreno510/danny-robot/cad/print/torso_left_cover.stl

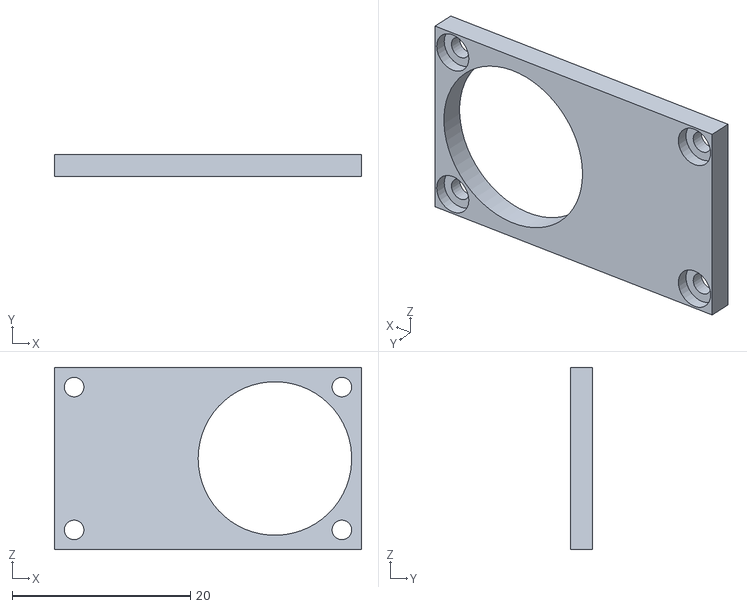
[picture p44: CAD file, 2026-10-31]
cad/print/torso_left_cover.stl
34.4 x 2.50 x 20.4
