danielmoreno510/danny-robot/cad/print/torso_chest_pad.stl

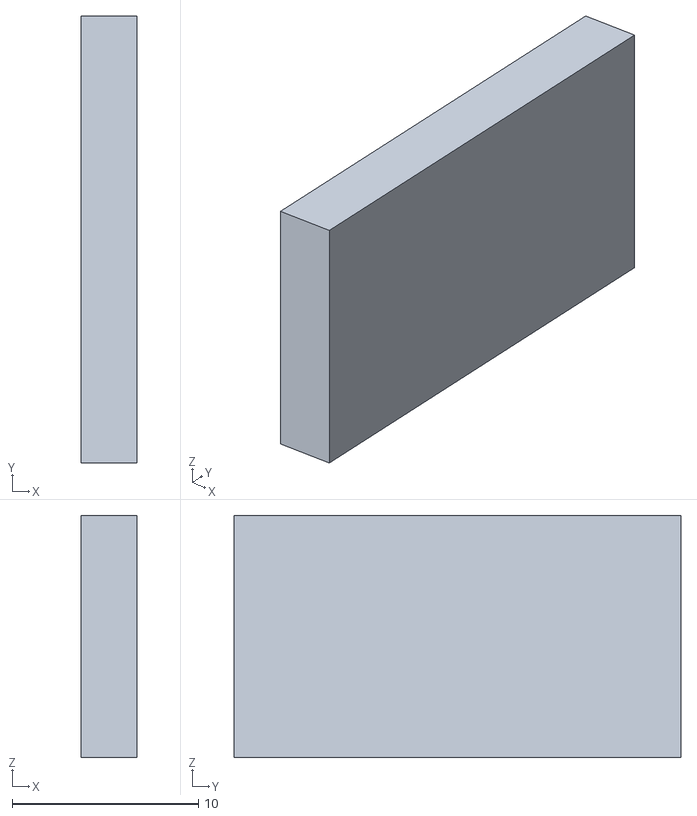
[picture p45: CAD file, 2026-10-31]
cad/print/torso_chest_pad.stl
3.00 x 24.0 x 13.0
