danielmoreno510/danny-robot/cad/print/base_link_panel.stl

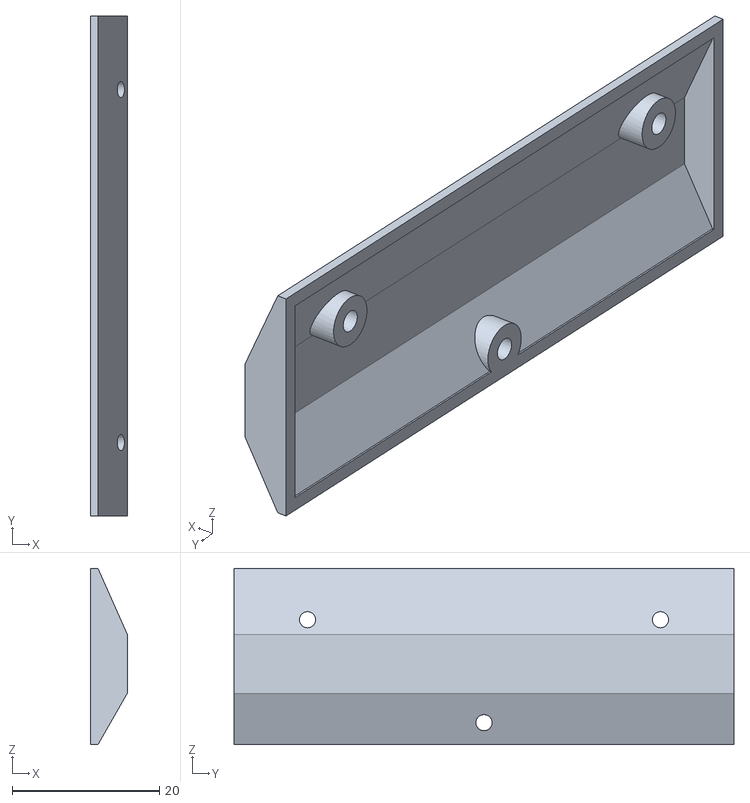
[picture p47: CAD file, 2026-10-31]
cad/print/base_link_panel.stl
5.00 x 68.0 x 24.0
