danielmoreno510/danny-robot/cad/print/head_cover.stl

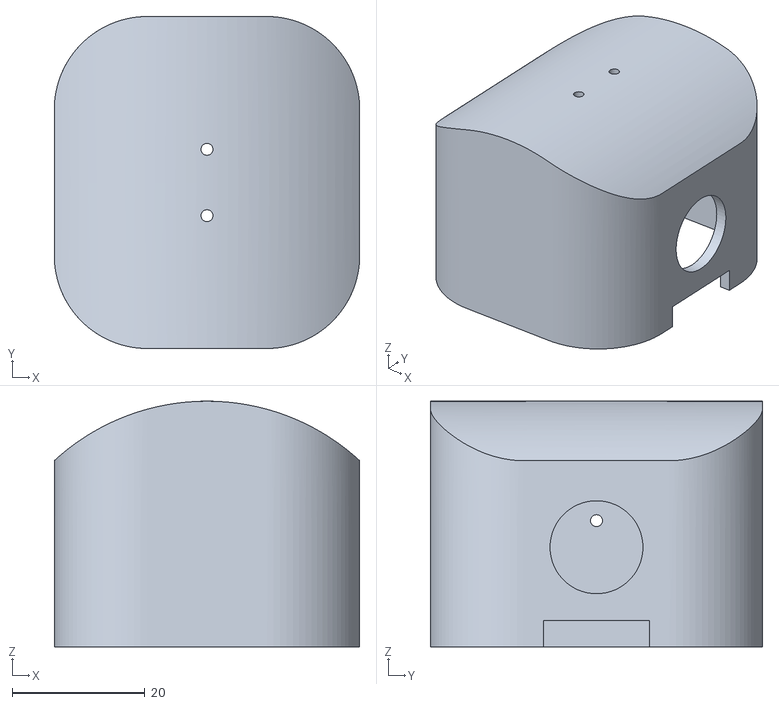
[picture p48: CAD file, 2026-10-31]
cad/print/head_cover.stl
46.0 x 50.0 x 37.0
