danielmoreno510/danny-robot/cad/print/torso_chest_panel.stl

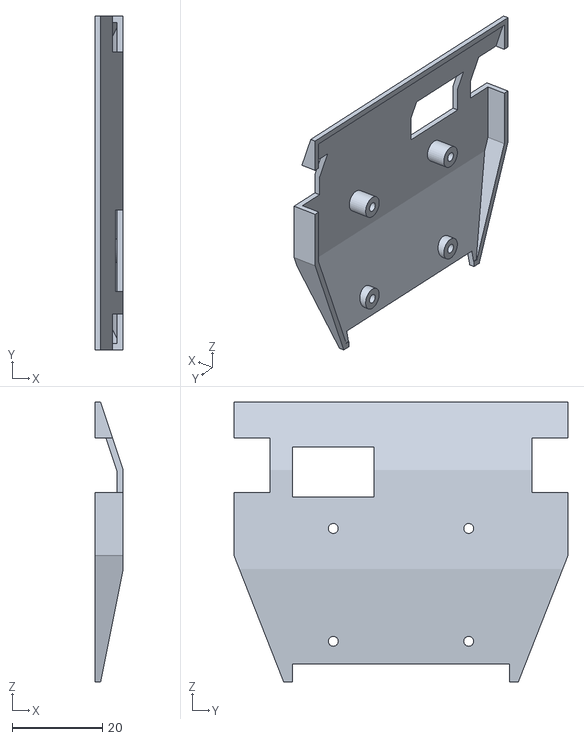
[picture p49: CAD file, 2026-10-31]
cad/print/torso_chest_panel.stl
6.30 x 74.0 x 62.0
