danielmoreno510/danny-robot/cad/print/head_left_cover.stl

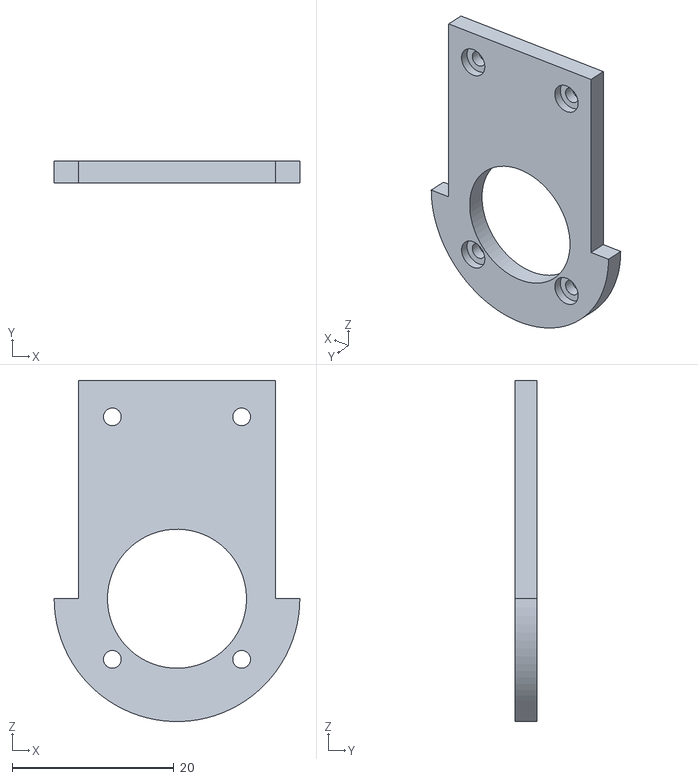
[picture p50: CAD file, 2026-10-31]
cad/print/head_left_cover.stl
30.4 x 2.70 x 42.2
