danielmoreno510/danny-robot/(list of files, cad)

Other CAD files:
cad/export/danny/meshes/left_shin_1.stl
cad/print/left_hip_roll_link_plate.stl
cad/export/danny/meshes/right_foot_1.stl
cad/print/right_hip_yaw_link_structure.stl
cad/export/danny/meshes/left_thigh_1.stl
cad/print/right_shin_panel.stl
cad/export/danny/meshes/left_hip_yaw_link_1.stl
cad/export/danny/meshes/left_hip_roll_link_1.stl
cad/print/left_hip_roll_link_cover.stl
cad/export/danny/meshes/right_upper_arm_1.stl
cad/print/right_hip_yaw_link_cover.stl
cad/export/danny/meshes/left_forearm_1.stl
cad/print/left_thigh_structure.stl
cad/export/danny/meshes/left_ankle_link_1.stl
cad/print/left_hip_roll_link_structure.stl
cad/print/right_foot_structure.stl
cad/print/left_shin_structure.stl
cad/export/danny/meshes/right_shoulder_link_1.stl
cad/export/danny/meshes/left_elbow_link_1.stl
cad/print/right_upper_arm_plate.stl
cad/print/right_upper_arm_cover.stl
cad/print/left_upper_arm_structure.stl
cad/print/left_thigh_panel.stl
cad/print/left_forearm_structure.stl
cad/print/right_shoulder_link_structure.stl
cad/print/base_link_structure.stl
cad/print/left_elbow_link_structure.stl
cad/print/right_forearm_cover.stl
cad/print/right_elbow_link_structure.stl
cad/print/torso_right_cover.stl
cad/print/left_foot_sole.stl
cad/print/neck_link_structure.stl
cad/print/right_ankle_link_structure.stl
cad/print/left_shin_cover.stl
cad/print/right_shin_pad.stl
cad/print/left_ankle_link_structure.stl
cad/print/left_shoulder_link_structure.stl
cad/print/left_thigh_cover.stl
cad/print/torso_left_back_pad.stl
