danielmoreno510/danny-robot/(commit log)

2026-10-29 Humanoide H1 en MuJoCo: etapas 1 a 9
    Simulación paso a paso de un humanoide, desde un cubo que cae hasta una
    pierna de 6 GDL con pie plano que hace sentadillas apoyada en el suelo.
    - Modelos: falling_box, single_joint, leg_2dof, leg_2dof_foot, leg_6dof.
    - leg_control.py: perfil coseno, compensación de gravedad en el aire y en
    apoyo, utilidades de sensores.
    - Análisis con criterios de aceptación: analyze_leg_2dof, squat_leg_2dof,
    analyze_leg_6dof (todos PASS).
    - README.md: handbook con instalación, convenciones, etapas, resultados y
    lecciones aprendidas.
2026-10-30 Etapa 10: bípedo con pelvis libre en equilibrio sobre un pie
    - biped_6dof.xml: dos piernas de 6 GDL, pelvis con freejoint e IMU.
    - balance_biped.py: de pie, sentadilla, cambio de peso y pie derecho
    5 cm en el aire. PASS con inclinación de pelvis < 1°.
    - leg_control.py: leg_ik (cinemática inversa analítica) y
    StanceCompensator con varios pies, fracción de peso por pie y punto
    de aplicación de la fuerza (bajo el centro de masas).
    - README: etapa 10, resultados, lecciones, glosario y hoja de ruta.
2026-10-30 Etapa 11: primeros pasos del bípedo en marcha estática
    - walk_biped.py: 4 pasos de 8 cm con el CdM siempre sobre un pie;
    avanza 27,9 cm con cada pie a < 1,5 mm de donde se colocó. Comprueba
    el alcance de cada pose antes de simular.
    - biped_control.py: Pose, Biped, IK de las dos piernas, reparto del peso
    y center_com_over, compartidos por las etapas 10 y 11.
    - Feedforward de velocidad en Biped.step: el motor de posición ya no se
    retrasa (kv/kp)·q̇ en movimiento. Era la causa de que los pies poco
    cargados se movieran.
    - interpolate acepta una duración; las transiciones largas duran más.
    - README: etapa 11, comparación de intentos, números de la etapa 10 con
    feedforward, l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
2026-10-30 Etapa 12: la misma marcha en la mitad de tiempo
    - walk_biped.py: opciones --speed (transiciones), --hold (pausas) y
    --dynamic. Con --speed 1.27 --hold 0.25 la marcha tarda 27,1 s en lugar
    de 54,3 s y pasa todos los criterios con la compensación estática.
    - La causa era el plan: 25,5 s eran pausas. Recortarlas evita acelerar
    los movimientos al doble, que llevaba el ZMP a 8 mm del borde del pie.
    - Compensación dinámica opcional: StanceCompensator acepta dinámica
    inversa y Biped.required_contact calcula la fuerza del suelo y el ZMP
    exacto. Sigue desactivada por defecto porque inclina más la pelvis;
    la causa está pendiente. Las etapas 10 y 11 no cambian.
    - README: etapa 12, co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
2026-10-30 Etapa 13: marcha más natural con pasos largos y giro
    - walk_biped.py: opciones --knee, --step, --width, --inset y --turn.
    Con la configuración de la etapa 13 da 4 pasos de 12 cm y gira 45° en
    otros 4, en 50,6 s, con la mitad de balanceo lateral. Por defecto
    reproduce las etapas 11 y 12.
    - footsteps: lista de pisadas (pie, posición, giro) que puede curvarse.
    - biped_control.py: Pose guarda el giro de pelvis y pies, joint_targets
    usa hip_yaw y center_com_over acepta dejar el CdM hacia dentro del pie.
    - Criterios nuevos: giro de pelvis y pies respecto al plan, pies sin
    tocarse y margen del CdM en los ejes del pie.
    - README: etapa 13, tablas de parámetros y resultados, lección y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
2026-10-30 Roadmap maestro y experimento 14: paso de recuperación
    - ROADMAP.md: plan del proyecto en 12 fases y 76 etapas, con el estado
    revisado y los experimentos que cubren las fases 1 a 3.
    - Lo que antes eran etapas del README pasan a llamarse experimentos,
    en documentación, código y modelos.
    - recover_biped.py: paso de recuperación ante empujones. Aguanta 50 N
    adelante y 48 N atrás (se exigían 30 N). De lado aguanta 32 N de los
    36 N exigidos: el experimento sigue en FAIL.
    - biped_control.py: punto de captura, y pierna en el aire calculada
    desde la pelvis medida.
    - README: experimento 14, hipótesis descartadas y limitaciones. El paso
    aún no es realista: faltan límites de veloci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
2026-10-30 Robot Danny: etapa 19, comprobaciones y documentación ordenada
    - El proyecto y el robot pasan a llamarse Danny.
    - Etapa 19 cerrada con límites definidos sin dar un paso: push_biped.py
    comprueba 23 N adelante, 24 N atrás y 25 N de lado, con curva de
    par-velocidad. Corrige el dato anterior de 50 N, que era un salto.
    - Se retira recover_biped.py: el paso de recuperación pasa a la etapa 26.
    - run_checks.py ejecuta las 9 comprobaciones y guarda métricas en results/.
    - check_kinematics.py valida la IK contra MuJoCo, y la marcha comprueba
    los rangos articulares al planificar. Fase 2 completa.
    - Documentación: README corto, docs/HANDBOOK.md con el detalle y
    CLAUDE.md con reglas y estad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
2026-10-30 Etapa 18: corrige el reparto de la compensación dinámica entre pies
    - Causa: con dos pies, el peso real sigue al CdM, no al ZMP, y la fuerza
    horizontal no se reparte en proporción. Con un pie la fórmula ya era
    correcta. Ahora, con dos pies, reparto por CdM y fuerza vertical.
    - Añade la aceleración de giro de la pelvis: vale con --turn.
    - Sigue siendo opcional (--dynamic): empata a ritmo normal y mejora a
    doble velocidad, de 16 fallos a 1 en la marcha con giro.
    - run_checks.py añade E15: 10 comprobaciones.
    - Documentación: experimento 15, roadmap, README y CLAUDE.md.
2026-10-30 Fase 3 completada: cuerpo de Danny y auditoría
    - danny.xml: 70 cm y 8 kg, con torso provisional y armature en las
    articulaciones, que elimina una vibración de 12 Hz. Sustituye a
    biped_6dof.xml. Etapa 13 cerrada.
    - Auditoría de la etapa 20, con revisión independiente del código:
    métricas también durante el movimiento, y controlador ciego: calcula
    el CdM con su modelo nominal, no con el estado real.
    - Se elimina la compensación dinámica: no aporta con este cuerpo.
    Etapa 18 cerrada como probada y no adoptada.
    - run_checks.py: 16 comprobaciones, con robustez ante masas, torso,
    fricción y paso de simulación.
    - Límite conocido: el control no corrige con la IMU. Un error de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
2026-10-30 Auditoría de la fase 3: CONDITIONAL PASS
    - tests/: suite de validación automática sin visor, 117 pruebas, con
    cinemática analítica independiente y estados medidos. Las métricas se
    guardan en results/phase3_metrics.json. Las pruebas de realismo miden
    sin exigir: registran qué rompe la marcha.
    - documentation/phase-3-validation.md: informe generado con esas cifras.
    - danny.xml: kv de tobillo calculado para carga en apoyo (zeta ~ 0,6). La
    recuperación tras un empujón baja de 1,9-2,7 s a 1,1-1,4 s.
    - Los nombres de la pierna de 2 GDL pasan a leg_control.py: ningún
    script de análisis importa de otro.
    - Roadmap: etapas 18 y 19 en parcial. Equilibrio activo y compensación
    di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
2026-10-30 Prepara la fase 3.5: correcciones de la auditoría y propuesta aprobada
    - leg_ik lanza UnreachableTargetError en vez de recortar en silencio, y
    joint_targets comprueba los 12 rangos con JointLimitError.
    - danny.xml: autocolisión de todo el cuerpo, con exclusiones explícitas
    entre pelvis y muslos.
    - Regresión: 124 pruebas y 16 comprobaciones, sin aflojar ningún límite.
    - documentation/known-limitations.md: equilibrio pasivo, actuadores
    idealizados y sensibilidad a perturbaciones.
    - documentation/phase-3.5-proposal.md: humanoide de 30 GDL, 70 cm y 10 kg
    provisionales, aprobado. Aún sin implementar.
    - ROADMAP: fase 3.5 añadida. El informe de la fase 3 conserva su
    CONDITIONAL PA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
2026-10-30 Etapas 3.5.1 y 3.5.2: presupuesto de 11 kg y modelo generado
    - documentation/phase-3.5-mass-budget.md: 30 motores de catálogo dan
    10,7 kg y otro reparto. Objetivo aprobado: 11 kg.
    - robot_spec.py es la única fuente de medidas, masas, articulaciones y
    motores. build_model.py genera danny_biped.xml con MjSpec, que
    sustituye a danny.xml y no se edita a mano.
    - Física sin cambios: 458 matrices idénticas, 126 pruebas, 16
    comprobaciones y 277 métricas iguales.
    - Las pruebas construyen sus variantes con MjSpec en vez de editar XML.
2026-10-30 Etapa 3.5.3: humanoide con torso y cintura
    Añade danny_humanoid.xml (11 kg, 14 GDL) con lastres en lugar de brazos y
    cabeza. Biped sirve para los dos modelos y los scripts aceptan --robot.
    E10 a E13 pasan, también moviendo la cintura; E12 usa 0,3 s de espera.
    El exceso de los empujones sobre la estimación sigue sin explicar (E18).
2026-10-30 Etapa 3.5.4: brazos de 7 GDL en postura fija
    El humanoide pasa a 28 GDL. Biped sujeta cintura y brazos, y set_pose los
    incluye para que el plan calcule el CdM con la postura real. Las pruebas
    encontraron un choque del codo con la pelvis al girar la cintura: los brazos
    se separan 15°. E10 a E13 pasan y los empujones se miden de nuevo (E19).
2026-10-30 Etapa 3.5.5: manos rígidas
    El lastre de la mano pasa a ser un bloque con colisión, sin dedos. La masa
    no cambia y marcha y empujones tampoco. Con 0,3 kg en la mano, los pares
    confirman el presupuesto de masa (E20).
2026-10-30 Etapa 3.5.6 y revisión para movimiento natural
    Añade cuello de 2 ejes y cabeza simple: el humanoide llega a 30 GDL (E21).
    La revisión del cuerpo completo mide balanceo de brazos, actuadores y
    escalado, y propone cambios antes de la fase 4. El roadmap incluye los hitos
    de movimiento natural con criterios medibles.
2026-10-30 Motor por articulación, roll de cintura y auditoría de la fase 4
    El humanoide pasa a 31 GDL. Cada articulación usa su motor de catálogo y
    la curva de par-velocidad queda siempre activa (E22). E12 necesita 0,35 s de
    espera. La auditoría concluye que aún no se puede entrenar y lista lo que
    falta. PROJECT_HANDOFF.md permite seguir desde otro chat o computadora.
2026-10-30 Etapa 3.5.7: integración del cuerpo completo y cadera a 30°
    E13 con cintura, brazos y cuello en movimiento, IMU, velocidades
    articulares, postura stand y sensibilidad del humanoide. La auditoría
    automática usa masa -5 %: con -10 % un pie queda a 5,1 mm, y se documenta.
    La extensión de cadera del humanoide pasa de 90° a 30°.
2026-10-30 Etapa 3.5.8: validación de la fase y auditoría independiente
    Fase 3.5 en CONDITIONAL PASS, aceptada por el usuario. Informe y
    comparación con el bípedo. La curva de par-velocidad cuenta como
    saturación, center_com_over avisa si no converge, los topes se miden con
    2 veces el par neto y se separa el zeta pasivo del brazo del que tiene kv.
2026-10-30 Etapa 5.1: arquitectura mecánica y esqueleto para Fusion
    Cambio de plan: el diseño mecánico va antes del aprendizaje por refuerzo.
    Auditoría del modelo, estimación de cargas, motores, cómputo, coste y
    esqueleto paramétrico generado desde robot_spec.py. El script no se ha
    ejecutado en Fusion: se probó con un sustituto de su API.
2026-10-31 Reinicio del proyecto: humanoide compacto inspirado en XGO-Duck
    Nuevos requisitos, plan por etapas y comparación de actuadores. Lo anterior
    queda en la etiqueta archivo-danny-70cm.
2026-10-31 Etapa 1: arquitectura de 40 cm, desglose de piezas y handbook
    Altura aprobada de 40 cm con aspecto de Optimus, 23 GDL y Radxa Zero 3W.
    Añade desglose de piezas, medidas y precios, handbook de trabajo y comprobador
    de modelos exportados. El diseño va antes de la compra, y la voz queda reservada.
2026-10-31 Etapas 2 y 3: robot completo en CAD y primera simulación
    Robot de 395 mm con 24 eslabones y 23 articulaciones modelado por scripts en
    Fusion, con paneles, electrónica colocada y 62 STL. Añade el puente con Fusion,
    la comprobación automática y la capa de simulación en MuJoCo: se sostiene de pie
    y las tareas medidas cumplen el límite de par. Nada se ha impreso.
    [arm_link_1.stl, base_link.stl, base_link_cover.stl, base_link_panel.stl, base_link_structure.stl, head_1.stl, head_cover.stl, head_left_cover.stl]
2026-10-31 Etapa 3: colisiones, levantarse en simulación y guía de entrenamiento
    Añade colisiones simples, visor con tareas y grabaciones, y una búsqueda que
    demuestra que Danny puede levantarse del suelo, aunque de forma frágil. Corrige
    el atasco del visor. Exporta el modelo para entrenar y documenta la etapa 4 para
    hacerla en otra computadora con mjlab, sin haberlo probado en una GPU.
    [danny_motion.py, danny_sim.py, export_training_model.py, measure_joint_loads.py, search_get_up.py, search_roll_over.py, view_simulation.py]
2026-10-31 Registrar compras del banco de pruebas y siguiente paso
2026-11-01 Diagnosticar la marcha y fijar escalas de entrenamiento para Danny
2026-11-02 Primer intento de marcha en mjlab
2026-11-02 Anotar que la velocidad de marcha debe medirse en el tronco
2026-11-02 Documentar la protección de main y quién cambia el diseño
2026-11-02 Corregir bloqueos de la auditoría y simular con el servo BAM
    [left_forearm_1.stl, left_forearm_structure.stl, left_hip_roll_link_1.stl, left_hip_roll_link_cover.stl, left_hip_roll_link_plate.stl, left_hip_roll_link_structure.stl, left_thigh_1.stl, left_thigh_panel.stl]
2026-11-02 Validar el modelo de entrenamiento y corregir la segunda auditoría
    [base_link.stl, base_link_cover.stl, left_foot_1.stl, left_foot_structure.stl, left_hip_roll_link_1.stl, left_hip_roll_link_cover.stl, left_hip_roll_link_plate.stl, left_hip_roll_link_structure.stl]
2026-11-02 Marcha: reloj de marcha y modelo de la auditoría; camina hacia delante en simulación
2026-11-02 Medir el giro y corregir la orden fija: quitar los entornos de solo avance de mjlab
2026-11-02 Fase 0: modelo final, colisiones, masa compartida, bloqueo de par y plan por fases
2026-11-02 Fase 1: la marcha con el modelo final no aprueba; diagnóstico por contactos y visor con color
2026-11-02 Fase 1b: recompensa de separación entre suelas y recuento de choques entre eslabones; criterio
2026-11-02 Fase 1b: la marcha con el modelo final aprueba tras penalizar los choques entre pies
2026-11-02 Fase 2: criterio, etapas de aleatorización, holgura, armadura y evaluación por movimientos
2026-11-03 Fase 2: control 2 tras fase2_b, giro a la derecha no cumple
2026-11-03 Fase 2: resultado final de fase2_c, no cumple
2026-11-03 Fase 2: recompensa de giro mas exigente y plan del segundo intento
2026-11-03 Fase 2: fase2_e parada, analisis de la oscilacion y el giro corto
2026-11-03 Recompensa de giro doble, medidas de par por tension y caidas por condicion
2026-11-04 Fase 2, tercer intento: control de fase2_d_doble cumple los siete movimientos
2026-11-04 Fase 2, tercer intento: fase2_e_doble no cumple (guía 82,4 %, giro derecha 0,158, rodilla saturada a 6 V)
2026-11-04 Fijar 6,6 V como tensión mínima de marcha y los empujones de la guía en la prueba
2026-11-04 Elegir CMU y 100STYLE como fuentes de movimiento humano y cerrar la etapa 1
2026-11-04 Opción --push en las medidas y comparación fase2_d_doble / fase2_e_doble con empujones de la guía y 6,6 V
2026-11-04 Cumplir la fase 2 con fase2_f_rodilla: castigo de par sobre el 80 % del bloqueo en rodillas y tobillos
2026-11-04 Exportar y verificar el ONNX de la fase 2 y grabar vídeos de cada movimiento
2026-11-04 Escribir el criterio de la fase 3 (agacharse) antes de entrenar
2026-11-04 Actualizar el criterio de la fase 3 con el agachado inclinado del dueño y su comprobación estática
2026-11-04 Poner al día el relevo tras aprobar la Fase 2 y corregir sus finales de línea
2026-11-04 Fase 3: orden de altura, recompensas de agachado y medidas con altura; criterio de altura a 5 mm
2026-11-05 Fase 3 no cumple: se agacha quieto, pero la marcha agachada no baja y se pierde el giro
2026-11-05 Fase 3 segundo intento (fase3_quieto): no cumple, no sigue la orden de altura
    Politica de agacharse solo quieto (DANNY_STAND_ONLY), prueba de cambio de politica
    (measure_policy_switch.py), mediciones y diagnostico por puntos de control.
2026-11-05 Fase 3 aprobada (agacharse quieto, fase3_agacharse model_11994); diagnostico; criterio de la fase 4
    ONNX y video del agachado, prueba de cambio de politica, diagnostico del normalizador y
    puntos de control tempranos, saturacion en todas las articulaciones, criterio de la fase 4.
2026-11-10 Fase 6: siete gestos de pie aprobados (CMU), material recibido y primeras medidas del servo
    - Gestos de pie adaptados de CMU con piernas y pelvis fijas en la pose de pie:
    analysis/danny_gestures.py (lector ASF/AMC y cinemática inversa de brazos),
    analysis/retarget_gesture.py (adapta y mide el criterio), analysis/record_gesture_video.py
    y analysis/encode_video.swift (vídeo de la persona junto a Danny).
    - Aprobados por el dueño: saludar (141_16, x1,8 más lento), pedir ayuda con dos manos
    (141_16), dos conversaciones (18_08, 19_08), mope (141_27), dar la mano (141_23) y
    saludar con el brazo alto (143_25). Trayectorias a 50 Hz en results/retargeted/,
    informes en results/gesture_*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
    [cmu_13_26.csv, cmu_141_16.csv, cmu_141_16_dos_manos_amplitud0.5.csv, cmu_141_16_lento1.8.csv, cmu_141_18.csv, cmu_141_20.csv, cmu_141_21.csv, cmu_141_22.csv]
2026-11-10 Fase 6: diecisiete movimientos aprobados, con piernas en dos bailes
    - Gestos: tope de velocidad del servo (--speed-cap), brazo apartado del cuerpo
    (--body-margin), suavizado final contra la vibración (--smooth), margen a los
    topes (--limit-margin) y corte del clip (--end). Lo aprobado antes sale igual.
    - Aprobados: diez gestos de pie, cinco bailes con piernas fijas y dos Chicken Dance
    con piernas (143_34 hasta 5,4 s y 1,4 veces más lento, y 20_01).
    - Piernas (--legs, LegRetarget): la postura sale del cambio de la persona desde su
    postura de pie; la cinemática inversa mantiene el pie apoyado fijo y plano, el
    centro de masas dentro de la huella y el pie en el aire sin rozar.
    - El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
    [cmu_05_02.csv, cmu_05_12.csv, cmu_13_26.csv, cmu_141_12.csv, cmu_141_18.csv, cmu_141_20.csv, cmu_141_21.csv, cmu_141_22.csv]
2026-11-10 Fase 6: andar, dos intentos de referencia que no cumplen; se deja para el entrenamiento con física
    - --walk: postura desde el reposo de CMU, apoyo por velocidad (el suelo de la
    captura está inclinado), pisadas planificadas, pies hacia delante y centro de
    masas por control predictivo del ZMP (preview_com).
    - Rodillas simétricas y avance correcto, pero el pie se arrastra 1,3-5 cm y el
    ZMP queda en la huella el 34-55 %: no cumple. Decisión del dueño: el andar se
    pide al entrenar con física.
    Datos de CMU: obtenidos de mocap.cs.cmu.edu; la base se creó con fondos de NSF EIA-0196217.
    [cmu_07_01_piernas.csv, cmu_07_01_piernas_lento1.5.csv, cmu_07_02_piernas.csv, cmu_07_02_piernas_lento1.5.csv]
2026-11-10 Fase 6: criterio del entrenamiento con física de los 17 movimientos
    Criterio aprobado por el dueño el 11 de noviembre, con la lista de archivos, en la
    sección 4.4 de documentation/training-guide.md; relevo y ROADMAP al día.
2026-11-11 Fase 6: andar aprobado (CMU 07_01 y 07_02) con pasos de 0,10 m
    - Piernas al andar con mink: pie apoyado como restricción estricta, rangos y
    velocidad del servo como límites; altura del centro de masas con objetivo.
    - Control predictivo del ZMP con velocidad inicial; el pie que la persona
    lleva en el aire al empezar sigue apoyado.
    - Pisadas a escala de la cadera medida de Danny, acortadas a 0,65.
    - Pelvis con referencia en la media del clip al andar.
    - Hombro abierto 10° como mínimo al andar (el muslo tocaba el antebrazo).
    - Criterio: punto 2 a 25 mm de p95 al andar; punto 11 entre el primer y el
    último aterrizaje, a la escala de las pisadas. Aprobado por el dueño.
    - Vídeo: la c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
    [cmu_07_01_piernas.csv, cmu_07_02_piernas.csv]
2026-11-11 Fase 6: quitar los informes de andar ralentizado del segundo intento
    Están en el historial (fb3d73f); el tercer intento no los usa.
    [cmu_07_01_piernas_lento1.5.csv, cmu_07_02_piernas_lento1.5.csv]
